Francisco89/tesis/README.md

tesis
=====

El repositorio de mi tesis.
