Francisco89/tesis/Eclipse/Sources y Firmwares de ejemplo/ReadMe.txt

====== CYPRESS USBSUITE SOURCE CODE ==========
============================================== 
Following projects source code is included in this package.

1. CyAPI C++ Static Library.
2. CyUSB C#  DLL.
3. CyUSB3 WDF Kernel mode USB generic driver.

Following directories are included this package.

1.CyAPI_lib_cpp      :This directory contains CyAPI C++ Static Library source code.
  	
  ->ReadMe.txt       :Refer ReadMe.txt file  for more information on CyUSB library.
  
2.CyUSB_dll_csharp   :This directory contains CyUSB C#  DLL source code.

  ->ReadMe.txt       :Refer ReadMe.txt file  for more information on CyAPI library.
   
3.CyUSB3_sys_driver  :This directory contains CyUSB3 WDF kernel mode generic driver source code.

  ->ReadMe.txt       :Refer ReadMe.txt file  for more information on CyUSB3 driver.

4.License

  ->license.rtf      :Software license agreement file.

5.ReadMe.txt
