Francisco89/tesis/Eclipse/Sources y Firmwares de ejemplo/Firmware 300913/LedBlink/readme.txt

El proyecto de ejemplo sin ninguna modificacion. 

Saca una señal intermitente de 0.5 Hz.
