Francisco89/tesis/Informes/Opto/Informe de aislacion_version2.pdf

Titulo: Informe sobre aislaciones ópticas version 0.2
18 de marzo de 2014
autor: Francisco Luis Zurita

## 1 Introducción

En este informe se presenta la aislación a usar en cada canal de entrada y salida de tensión digital previo y posterior al conversor DA del proyecto de adquisición de señales de un banco de motores.

## 2 Especificaciones

El aislador especificado a utilizar es el 6N137, un aislador óptico rápido de 10M bit/s, que satisface nuestros requerimientos ya que la señal digital mas rápida que se necesita aislar es de 52kHz.

## 3 Diseño

El diseño del prototipo se enfoca en medir el comportamiento del aislador ante diferentes corrientes de excitación y condiciones de carga. Dicho diseño se basa en la nota de aplicación 71[1].


1

Para fijar la corriente de excitación se conmuta entre tres resistores por medio de un jumper. Las corrientes de entrada quedarán determinadas por el valor de dicha resistencia. Las mismas son:

I1 =

VCC1 − VLED − VEC
R1

=

5V − 1.4V − 0.2V
180Ω | = 18.9mA

I2 =

VCC1 − VLED − VEC
R2

=

5V − 1.4V − 0.2V
390Ω | = 8.71mA

I2 =

VCC1 − VLED − VEC
R3

=

5V − 1.4V − 0.2V
820Ω | = 4.14mA

El valor de VLED se obtiene de una curva de la hoja de datos y vale aproxi-madamente 1.4V .
Para fijar la carga se conmuta entre tres resistores de pull-up por medio de un jumper. Esta resistencia junto con la de la punta del osciloscopio y la capacitancia de dicha punta conforman el circuito RC de carga a la salida. Las cargas de salida son:

(R4||Rosc)||Cosc = 470Ω||10MΩ||10pF = 470Ω||10pF

(R5||Rosc)||Cosc = 1kΩ||10MΩ||10pF = 999.9Ω||10pF

(R6||Rosc)||Cosc = 10kΩ||10MΩ||10pF = 9.99kΩ||10pF

2

### 3.1 Listado de componentes

Resistores
Valor | Tolerancia | Cantidad | Referencia
180Ω | 5% | 1 | R1
390Ω | 5% | 1 | R2
820Ω | 5% | 1 | R3
470Ω | 5% | 1 | R4
1kΩ | 5% | 3 | R5,7,8
10Ω | 5% | 1 | R6
Capacitores
Valor | Tolerancia | Cantidad | Referencia
0.1 µF | 5% | 2 | C1,2
Circuitos Integrados
Modelo | Fabricante | Cantidad | Referencia
6N137 | ST | 1 | U1

3

## 4 Medición

### 4.1 Banco de Medición

Banco de Medición:

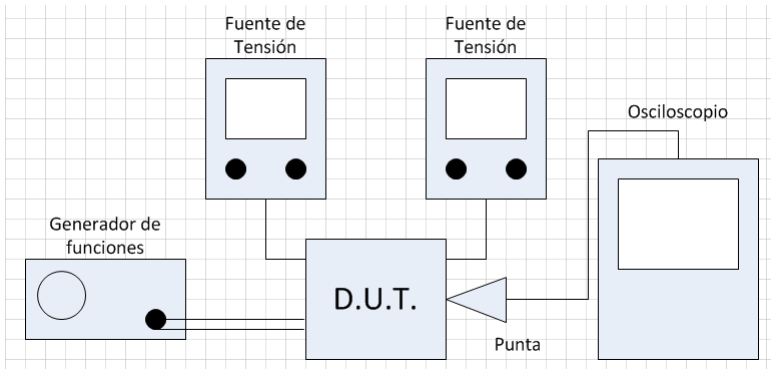
[picture p48: figure]

Figure 1: Banco de medición

- Fuente de Tensión Fair FR-305A 0 − 30V
- Fuente de Tensión Zurich DF1730SB5A 0 − 30V
- Osciloscopio Fluke 192B 60MHz, 500MS/s
Sensibilidad 2mV - 100V/div
Rango de la base de tiempos: 10 ns - 2 min/div
- Punta Fluke VP200 10:1 200MHz, 1.000 V CAT II/600 V CAT III (EN61010-1)
- Generador de Funciones Hing Chang Sweep 9205
Frecuencia: 0.02Hz a 2MHz 7 rangos
Precisión: ±5% (20KHz), ±8%(2MHz)

Rise-time del conjunto generador-punta-osciloscopio: 56.8ns.

Tensión de alimentación de entrada: 5V
Tensión de alimentación de salida: 3.3V
Señal de entrada: Tren de pulsos 0 − 5V a 10kHz

4

### 4.2 Imágenes

¡Reservado para foto¿

### 4.3 Resultados

A continuación mostramos los resultados de las mediciones de retardo, rise-time (tiempo transcurrido entre el 10% y el 90% de la transición de estado bajo a estado alto de la señal) y fall-time (tiempo transcurrido entre el 10% y el 90% de la transición de estado alto a estado bajo de la señal).

Rise-time


Figure 2: Medición de rise-time usando R2 = 390Ω y R4 = 470Ω: 39.6ns

5

Figure 3: Medición de rise-time usando R2 = 390Ω y R4 = 1kΩ: 68.8ns

6

Figure 4: Medición de rise-time usando R2 = 390Ω y R4 = 10kΩ: 628ns

7

Figure 5: Comparación de las figuras anteriores

Fall-time

8

Figure 6: Medición de fise-time usando R2 = 390Ω y R4 = 470Ω: 12ns

9

Figure 7: Medición de fise-time usando R2 = 390Ω y R4 = 1kΩ: 10ns

10

Figure 8: Medición de fise-time usando R2 = 390Ω y R4 = 10kΩ: 8.8ns

11

Figure 9: Comparación de las figuras anteriores

Retardo

12


Figure 10: Medición de retardo usando R1 = 180Ω y R5 = 1kΩ:75ns

13

Figure 11: Medición de retardo usando R2 = 390Ω y R5 = 1kΩ:62.8ns

14


Figure 12: Medición de retardo usando R3 = 820Ω y R5 = 1kΩ:56ns

15

Figure 13: Comparación de las figuras anteriores

Corriente / Carga | 470Ω | 1kΩ | 10kΩ
I1 = 18.9mA | 75ns | 75ns | 76ns
I2 = 8.71mA | 62.8ns | 63.6ns | 62.8ns
I3 = 4.14mA | 56ns | 55.2ns | 56.8ns
Tabla de valores de Retardo.
Corriente / Carga | 470Ω | 1kΩ | 10kΩ
I1 = 18.9mA | 32.8ns | 67.2ns | 624ns
I2 = 8.71mA | 39.6ns | 68.8ns | 628ns
I3 = 4.14mA | 32ns | 67.8ns | 620ns
Tabla de valores de rise-time.
Corriente / Carga | 470Ω | 1kΩ | 10kΩ
I1 = 18.9mA | 9.2ns | 8.8ns | 8.0ns
I2 = 8.71mA | 12ns | 10ns | 8.8ns
I3 = 4.14mA | 17.6ns | 16.8ns | 9.2ns
Tabla de valores de fall-time.
Se observa de las mediciones anteriores que el retardo a la salida no depende de la condición de carga. A su vez, el rise-time y fall-time no dependen de la corriente de excitación.

16

## References

[1] AN71: 10MBd High-Speed Optocoupler Design Guide, Noviembre 2011, Vishay Semiconductors.

17
