Francisco89/tesis/Eclipse/Sources y Firmwares de ejemplo/Firmware 300913/LedParpadeante/readme.txt

El proyecto de ejemplo modificado. 

Saca una señal intermitente que se repite cada 3s, 2s en estado alto y 1s en estado bajo.
