Francisco89/tesis/Eclipse/Sources y Firmwares de ejemplo/Firmware 300913/LedPermanente/readme.txt

El proyecto de ejemplo modificado. 

Saca una en estado alto todo el tiempo.
