Francisco89/tesis/Informes/Precios/Informe de precios.tex

	\documentclass[12pt,a4paper]{article}
\usepackage[utf8]{inputenc}
\usepackage{amsmath}
\usepackage{amsfonts}
\usepackage{amssymb}
\usepackage{graphicx}
\usepackage[spanish]{varioref}
\usepackage{hyperref}
\usepackage{float}
\begin{document}
\setlength{\parindent}{0cm}

Titulo: Informe sobre la adquisición de los conversores AD y DA\\
version 0.1\\
17 de marzo de 2014\\
autor: Francisco Luis Zurita\\

\section{Introducción}

En el presente informe se detalla la búsqueda del conversor ADC7656 y del conversor AD5422, necesarios para el proyecto de adquisición de señales de un banco de motores.

\section{Resumen de componentes}

\begin{tabular}{| l | l | l | l | l |} \hline
Proveedor & N$^\circ$ de parte & Cantidad & Precio unitario & Precio total\\ \hline
YEL & AD7656BSTZ & 5 & U\$S $52.983$ & U\$S $264.915$ \\ \hline
YEL & AD5422AREZ & 3 & U\$S $27.410$ & U\$S $82.230$ \\ \hline \hline
Total & & & & U\$S $347.145$\\ \hline
\end{tabular}

NOTA: Productos cotizados al 11 de marzo de 2014.

\end{document}
