Francisco89/tesis/Informes/Precios/Informe de precios_version2.pdf

Titulo: Informe sobre la adquisici´on de los conversores AD y DA version 0.1
17 de marzo de 2014
autor: Francisco Luis Zurita

## 1 Introducci´on

En el presente informe se detalla la b´usqueda del conversor ADC7656 y del conversor AD5422, necesarios para el proyecto de adquisici´on de se˜nales de un banco de motores.

## 2 Resumen de componentes

Proveedor | N◦ de parte | Cantidad | Precio unitario | Precio total
YEL | AD7656BSTZ | 5 | U$S 52.983 | U$S 264.915
YEL | AD5422AREZ | 3 | U$S 27.410 | U$S 82.230
Total | | | | U$S 347.145
NOTA: Productos cotizados al 11 de marzo de 2014.

1
