Francisco89/tesis/Informes/Filtro/Libro1.xlsx

Frecuencia | desfasaje/div | div | fase | log | - | ARG
1 | 0 |  | 0 | 0 | 0 | 0
2 | 0 |  | 0 | 0.3010299957 | 0 | 0
3 | 0 |  | 0 | 0.4771212547 | 0 | 0
4 | 0 |  | 0 | 0.6020599913 | 0 | 0
5 | 0 |  | 0 | 0.6989700043 | 0 | 0
6 | 0 |  | 0 | 0.7781512504 | 0 | 0
7 | 0 |  | 0 | 0.84509804 | 0 | 0
8 | 0 |  | 0 | 0.903089987 | 0 | 0
9 | 0 |  | 0 | 0.9542425094 | 0 | 0
10 | 0 |  | 0 | 1 | 0 | 0
20 | 0 |  | 0 | 1.301029996 | 0 | 0
30 | 0 |  | 0 | 1.477121255 | 0 | 0
40 | 0 |  | 0 | 1.602059991 | 0 | 0
50 | 0 |  | 0 | 1.698970004 | 0 | 0
60 | 0 |  | 0 | 1.77815125 | 0 | 0
70 | 0 |  | 0 | 1.84509804 | 0 | 0
80 | 0 |  | 0 | 1.903089987 | 0 | 0
90 | 0 |  | 0 | 1.954242509 | 0 | 0
100 | 0 |  | 0 | 2 | 0 | 0
200 | 0 |  | 0 | 2.301029996 | 0 | 0
300 | 0 |  | 0 | 2.477121255 | 0 | 0
400 | 0.1 | 0.0005 | 7.2 | 2.602059991 | -7.2 | -7.2
500 | 0.2 | 0.0002 | 7.2 | 2.698970004 | -7.2 | -7.2
600 | 0.2 | 2e-05 | 0.864 | 2.77815125 | -0.864 | -0.864
700 | 0.2 | 2e-05 | 1.008 | 2.84509804 | -1.008 | -1.008
800 | 0.2 | 2e-05 | 1.152 | 2.903089987 | -1.152 | -1.152
900 | 0.2 | 0.0002 | 12.96 | 2.954242509 | -12.96 | -12.96
1000 | 1.6 | 2e-05 | 11.52 | 3 | -11.52 | -11.52
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
