Francisco89/tesis/Informes/material/diseno/GPIO DATA_Plots.xlsx

Sheet: IOL_1.63V_00
IO VDD | IOL/ IOH | Drive Strength | Forced VDD | Unit#1 |  |  |  |  |  |  |  | Unit#2 |  |  |  |  |  |  |  | Unit#3 |  |  |  |  |  |  |  | Unit#4 |  |  |  |  |  |  |  | Unit#5
 |  |  |  | GPIO#47 | GPIO#46 | GPIO#53 | GPIO#54 | GPIO#33 | GPIO#34 | GPIO#6 | GPIO#7 | GPIO#47 | GPIO#46 | GPIO#53 | GPIO#54 | GPIO#33 | GPIO#34 | GPIO#6 | GPIO#7 | GPIO#47 | GPIO#46 | GPIO#53 | GPIO#54 | GPIO#33 | GPIO#34 | GPIO#6 | GPIO#7 | GPIO#47 | GPIO#46 | GPIO#53 | GPIO#54 | GPIO#33 | GPIO#34 | GPIO#6 | GPIO#7 | GPIO#47 | GPIO#46 | GPIO#53 | GPIO#54 | GPIO#33 | GPIO#34 | GPIO#6 | GPIO#7
1.63 | IOL | 00 | 0 | -0.02 | -0.02 | -0.06 | -0.06 | -0.02 | 0.11 | -0.02 | -0.02 | -0.07 | -0.04 | -0.06 | -0.06 | -0.02 | -0.02 | -0.02 | -0.02 | -0.02 | -0.02 | -0.06 | -0.06 | -0.02 | -0.02 | -0.02 | -0.02 | -0.02 | -0.02 | -0.06 | -0.06 | -0.02 | -0.02 | -0.02 | -0.02 | -0.08 | -0.02 | -0.06 | -0.06 | -0.02 | -0.02 | -0.02 | -0.02
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
