Francisco89/tesis/Informes/Filtro/img/filtro3.PNG

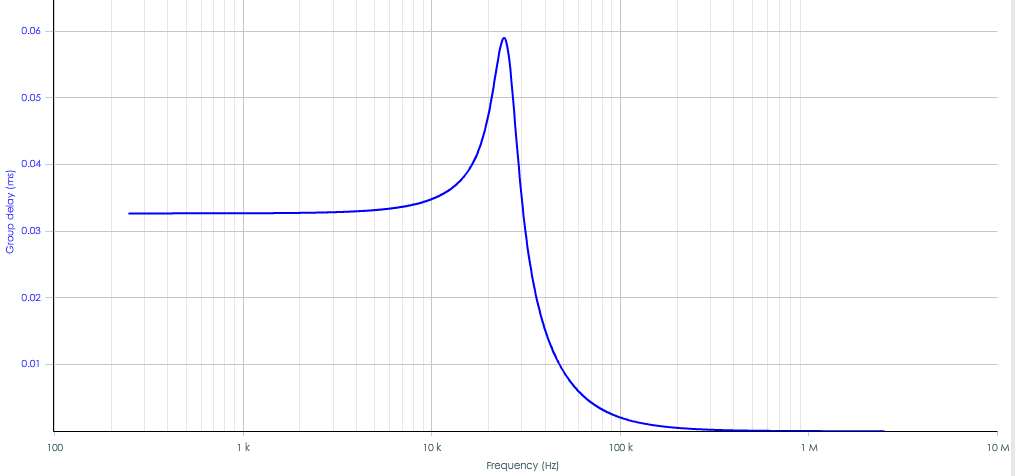
Informes/Filtro/img/filtro3.PNG
