Francisco89/tesis/Informes/Filtro/img/filtro9.PNG

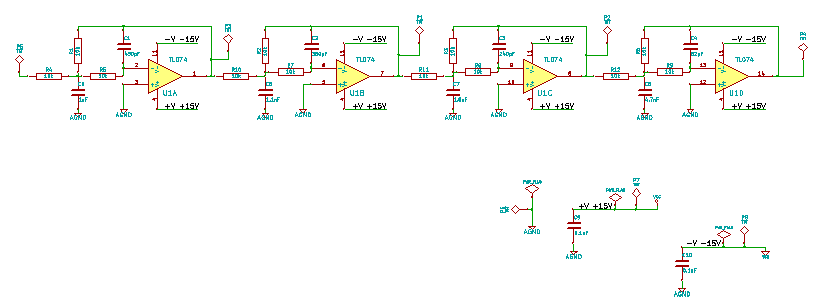
Informes/Filtro/img/filtro9.PNG
