Francisco89/tesis/Informes/Filtro/img/filtro10.PNG

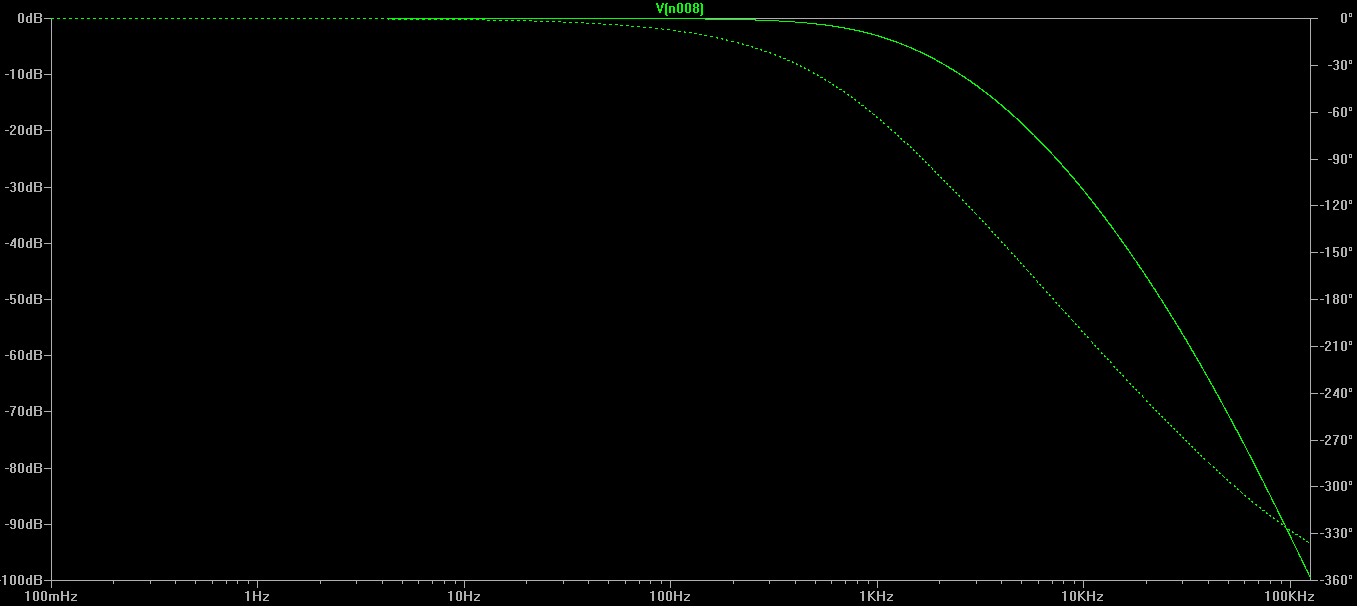
Informes/Filtro/img/filtro10.PNG
