Francisco89/tesis/Informes/Filtro/img/filtro11.PNG

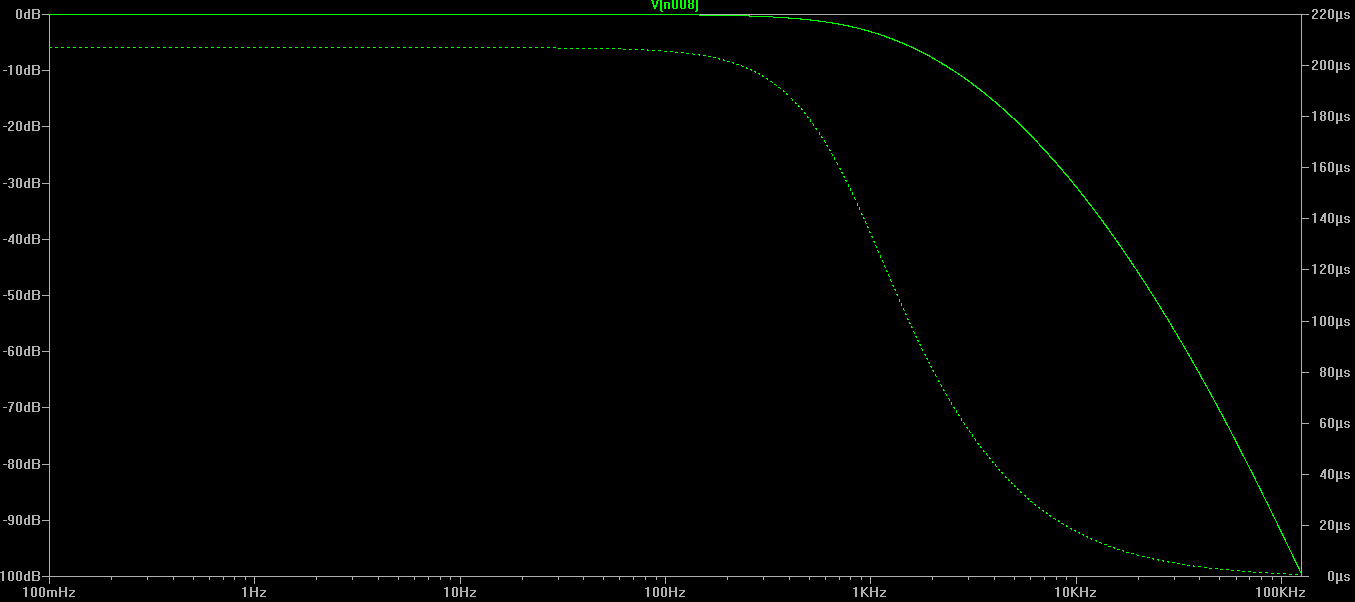
Informes/Filtro/img/filtro11.PNG
