Francisco89/tesis/Informes/Filtro/img/foto2.png

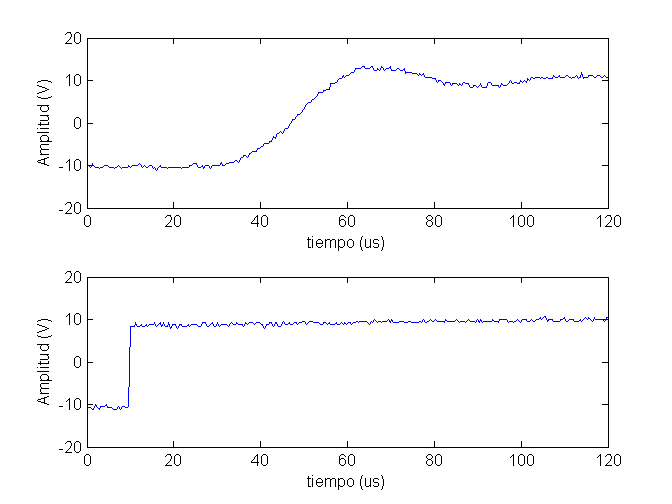
Informes/Filtro/img/foto2.png
