Francisco89/tesis/Informes/Filtro/img/foto4.png

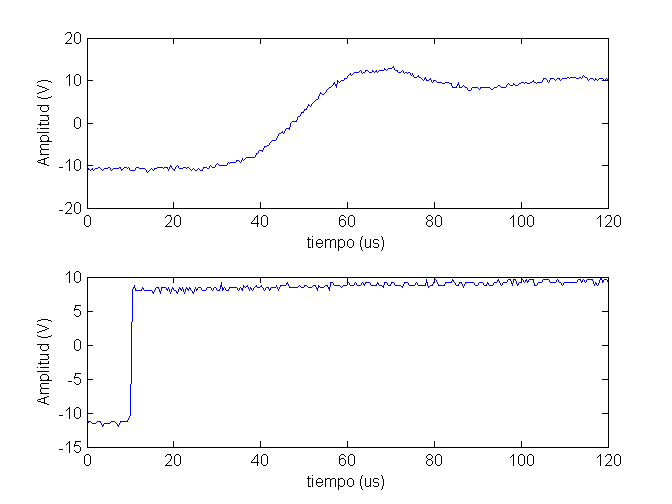
Informes/Filtro/img/foto4.png
