Francisco89/tesis/Informes/Filtro/img/foto5.png

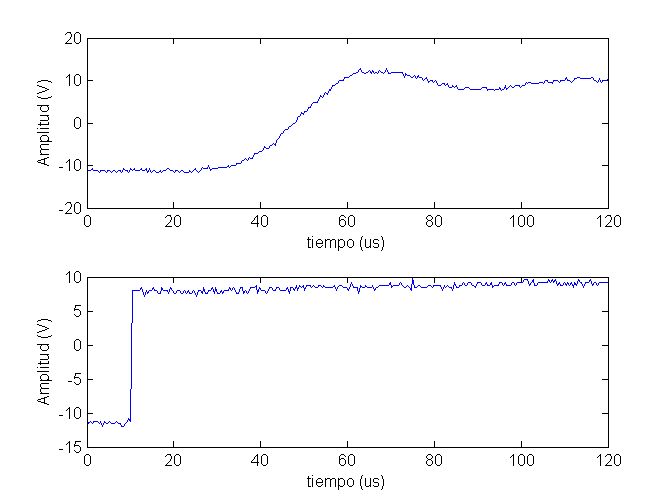
Informes/Filtro/img/foto5.png
