Francisco89/tesis/Informes/Filtro/img/foto7.png

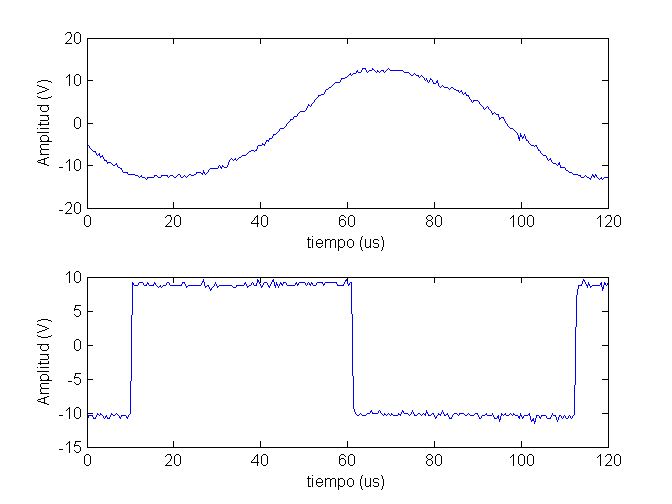
Informes/Filtro/img/foto7.png
