Francisco89/tesis/Informes/Filtro/img/foto8.png

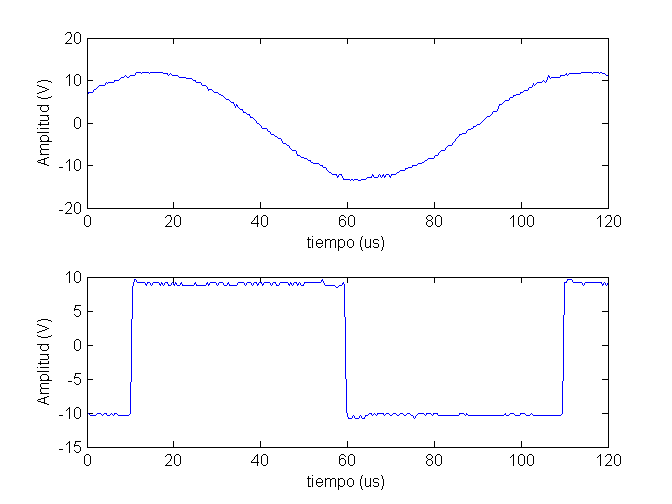
Informes/Filtro/img/foto8.png
