Francisco89/tesis/Informes/Filtro/img/foto9.png

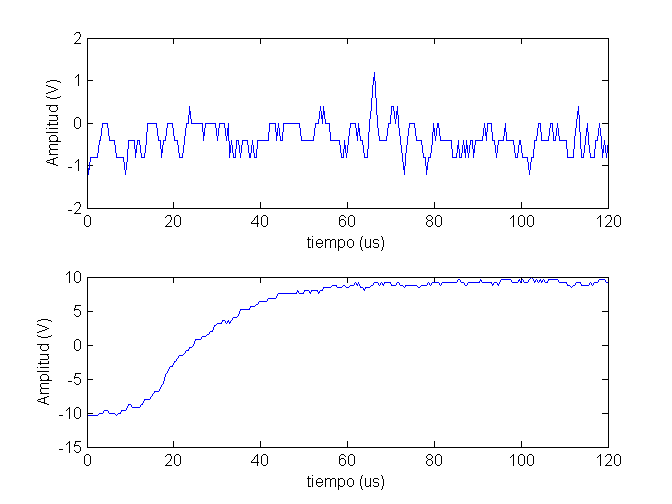
Informes/Filtro/img/foto9.png
