Francisco89/tesis/Informes/Filtro/img/retardo.PNG

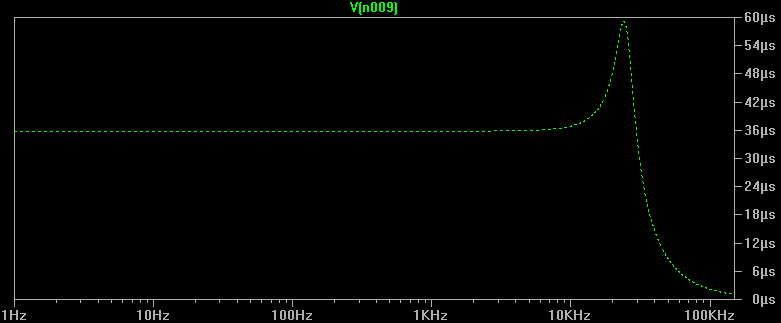
Informes/Filtro/img/retardo.PNG
