Francisco89/tesis/Informes/material/diseno/entrada2.PNG

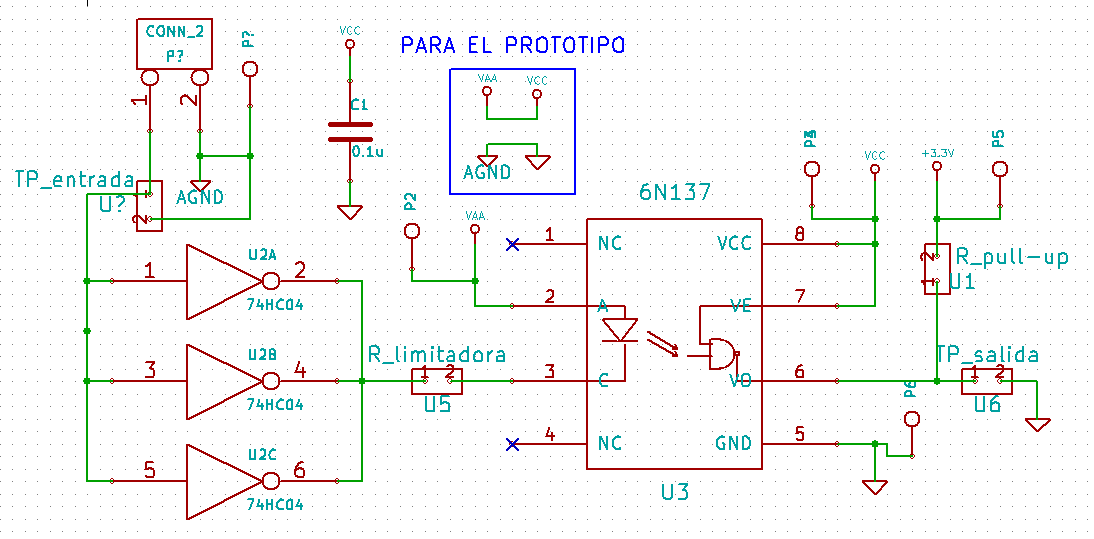
Informes/material/diseno/entrada2.PNG
