Francisco89/tesis/Informes/material/diseno/entrada_footprint.PNG

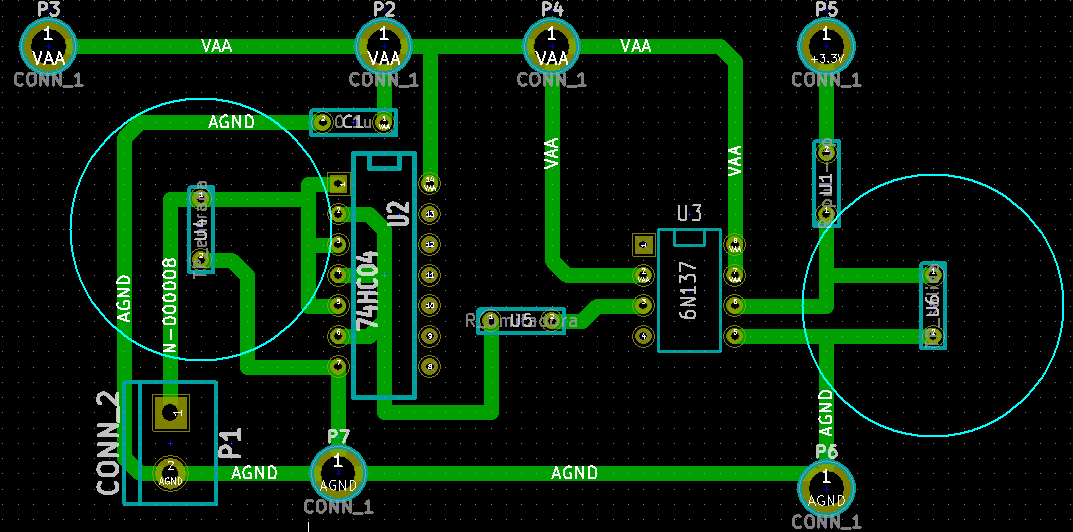
Informes/material/diseno/entrada_footprint.PNG
