Francisco89/tesis/Placa adquisidora/Componentes Placa.ods

 | Precio (por unidad)
 | RS | Mouser | Electronic Components | Digikey | Arrow | Empresa | Modelo | Bits | Settling time | Encapsulado | Interfaz | Salida | Comentarios
ADC
1 |  |  |  |  |  | Analog Devices | AD7656 | 16 | 3.1us | ST-64-2 | Serie/Paralelo | 0.2 a V_drive-0.2 | Es mas o menos el mismo tiempo de conversion en modo paralelo o serie
2
3
DAC
1 | POA | 14.15 a 26.82 | - | 6.69 a 15.35 | - | Texas Instruments | DAC8830 | 16 | 1us | SO-8 | SPI | 0 a +V_ref | Reset a zero code
2 | POA | 14.85 a 22 | - | 14.85 a 26.82 | - | Texas Instruments | DAC8831 | 16 | 1us | SO-14 y QFN-14 | SPI | -V_ref a +V_ref | Reset a zero code
3 | - | 10.48 (x148) | - | 12.16 a 15.22 | - | Texas Instruments | DAC8832 | 16 | 1us | QFN-14 | SPI | unipolar o bipolar | Reset a mid code
4 | POA | 22.48 | - | 22.0 | - | Texas Instruments | DAC8871 | 16 | 1us | TSSOP-16 | SPI | V_ref_H a V_ref_L | V_ref_H/L +/- 18V
5 | - | 10.0 | - | 10.0 | - | Analog Devices | AD5667R | 16 | 4us | LFCSP y MSOP-10 | I^2C | 0 a V_DD | Referencia interna
6 | - | 9.20 | - | 5 a 10 | - | Analog Devices | AD5667 | 16 | 4us | LFCSP y MSOP-10 | I^2C | 0 a V_DD | Referencia externa
7 | - | 10.0 | - | 5 a 10 | - | Analog Devices | AD5663R | 16 | 4us | LFCSP y MSOP-10 | SPI | 0 a V_DD | Ref int o ext
8 |  | 15.34 | - | 13 a 18 | - | Linear Tecnologies | LTC2641 | 16 | 1us | MSOP-8 y DFN | SPI | 0 a +V_ref
9 |  | - | - | 13 a 18 | - | Linear Tecnologies | LTC2642 | 16 | 1us | MSOP-10 y DFN | SPI | 0 a +V_ref y +/-V_ref
10 | - | - | - | - | - | Maxim | - | - | - | - | - | - | Solo de 12 bits
Aislador digital
1
2
3
Aislador analógico
1 |  |  |  |  |  |  | ISO124
2
3
Drivers analógicos
1 |  |  |  |  |  |  | AD8021
2 |  |  |  |  |  |  | AD8610
3 |  |  |  |  |  |  | AD797
