Francisco89/tesis/Informes/material/adq_retardos_hc04/retardo_de_bajada/retardo_de_bajada.JPG

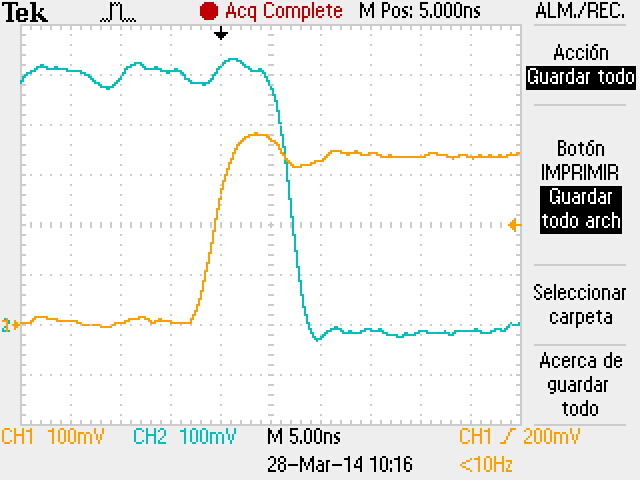
Informes/material/adq_retardos_hc04/retardo_de_bajada/retardo_de_bajada.JPG
