Francisco89/tesis/Informes/material/adq_retardos_hc04/retardo_de_subida/retardo_de_subida.JPG

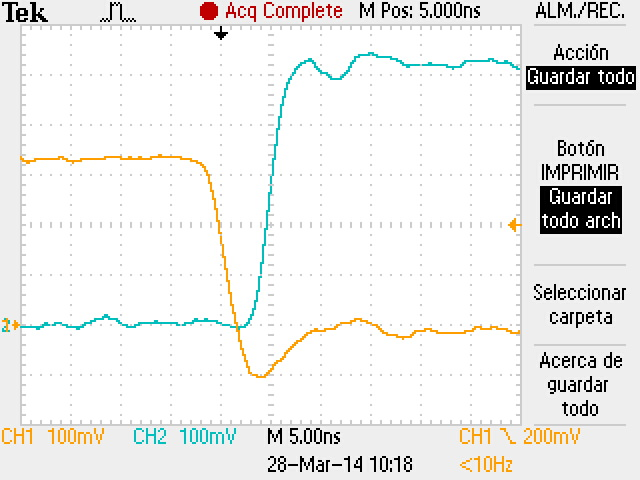
Informes/material/adq_retardos_hc04/retardo_de_subida/retardo_de_subida.JPG
