Francisco89/tesis/Placa adquisidora/placa yaki/Placa 02 _ Encoder #2.pdf

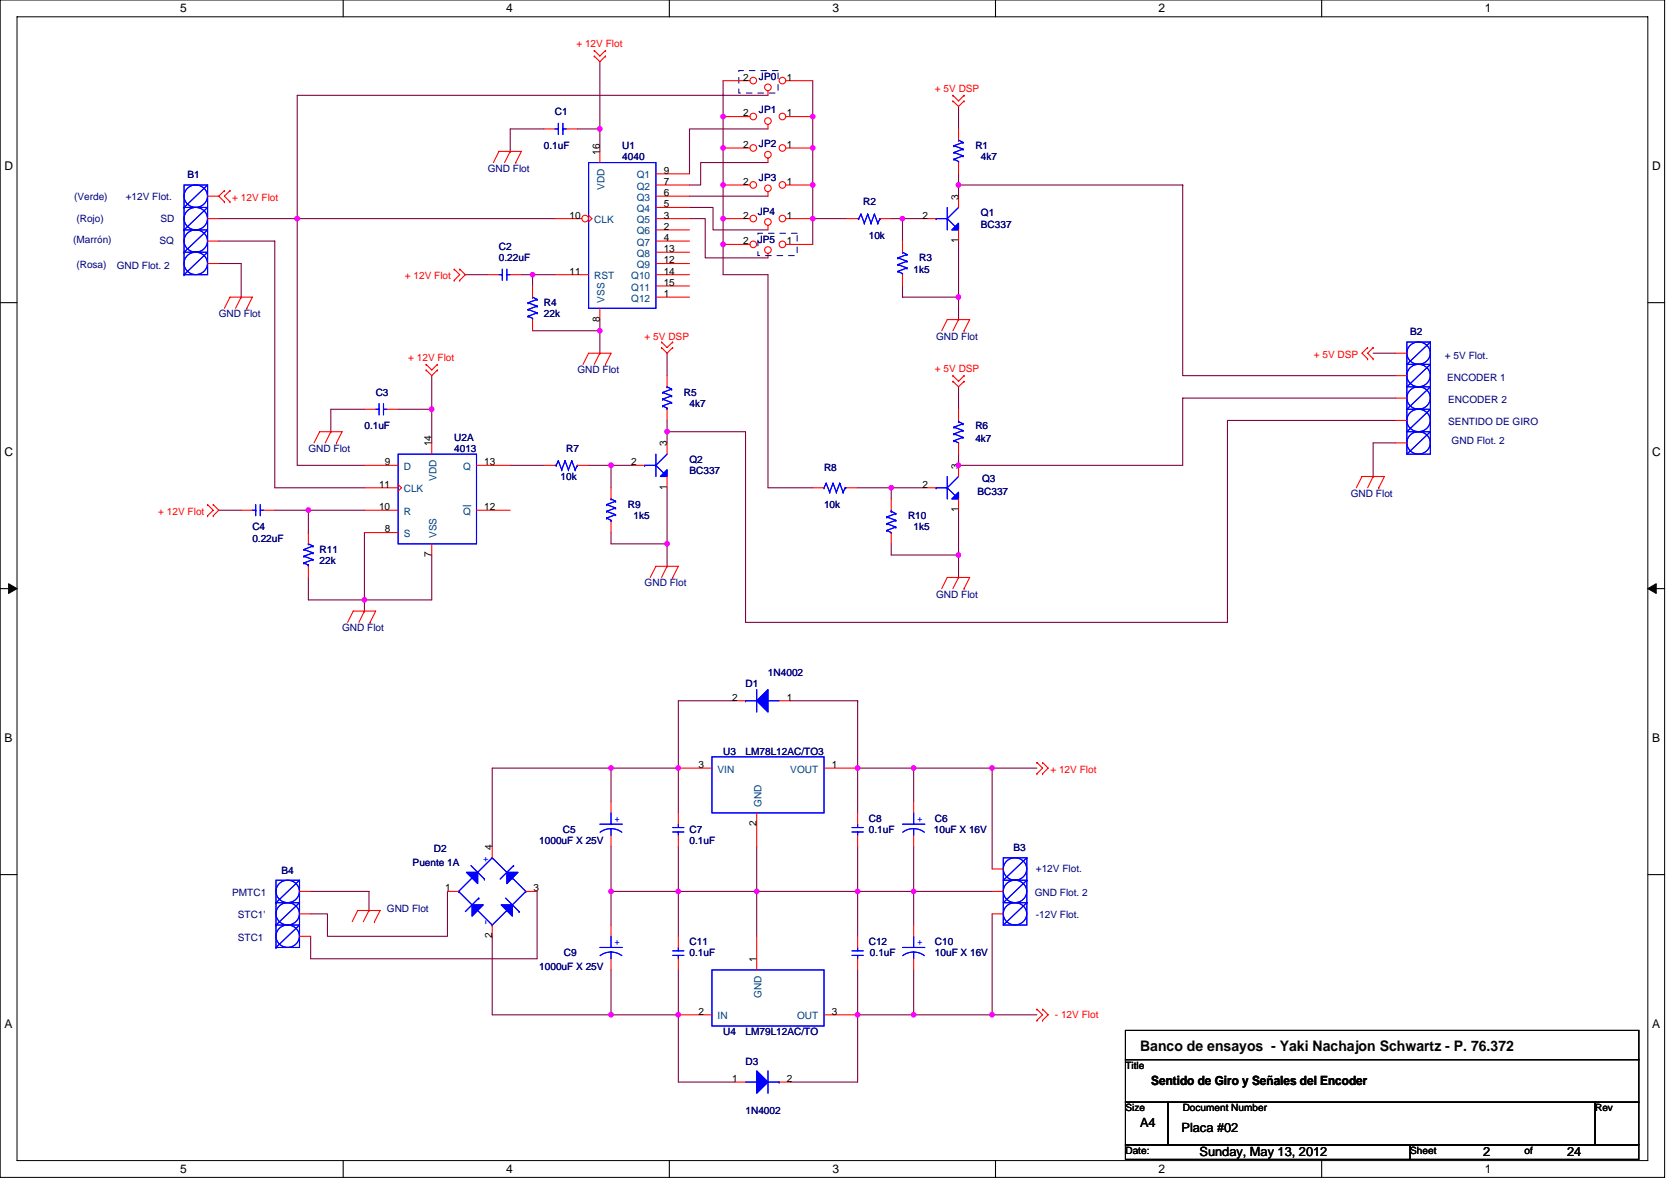
[picture p87: page 1]

Banco de ensayos - Yaki Nachajon Schwartz - P. 76.372

Title
Sentido de Giro y Señales del Encoder

Size Size Size A4 A4 A4 | Document Number Document Number Document Number Placa #02 Placa #02 Placa #02 | Rev Rev Rev

Date: Date: Date: Sunday, May 13, 2012 Sunday, May 13, 2012 Sunday, May 13, 2012 | Sheet Sheet Sheet 2 2 2 of of of 24 24 24
