Francisco89/tesis/Placa adquisidora/placa yaki/Placa 08 _ Filtro ANEXO PLACA #.pdf

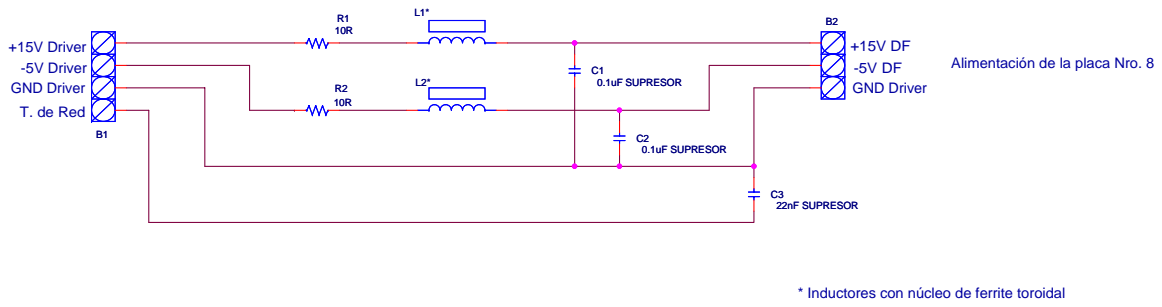
[picture p88: page 1]
+15V Driver -5V Driver GND Driver T. de Red; +15V DF -5V DF GND Driver; C1 0.1uF SUPRESOR; C2 0.1uF SUPRESOR; C3 22nF SUPRESOR

Alimentación de la placa Nro. 8

* Inductores con núcleo de ferrite toroidal

Banco de ensayos - Yaki Nachajon Schwartz - P. 76.372

Title
Filtro para las alimentaciones de la placa #08

Size Size Size A4 A4 A4 | Document Number Document Number Document Number Placa Anexo #08 Placa Anexo #08 Placa Anexo #08 | Rev Rev Rev

Date: Date: Date: Sunday, May 13, 2012 Sunday, May 13, 2012 Sunday, May 13, 2012 | Sheet Sheet Sheet 12 12 12 of of of 24 24 24
