Francisco89/tesis/Placa adquisidora/placa yaki/Placa 13 _ Placa #13 (CF-PWM).pdf

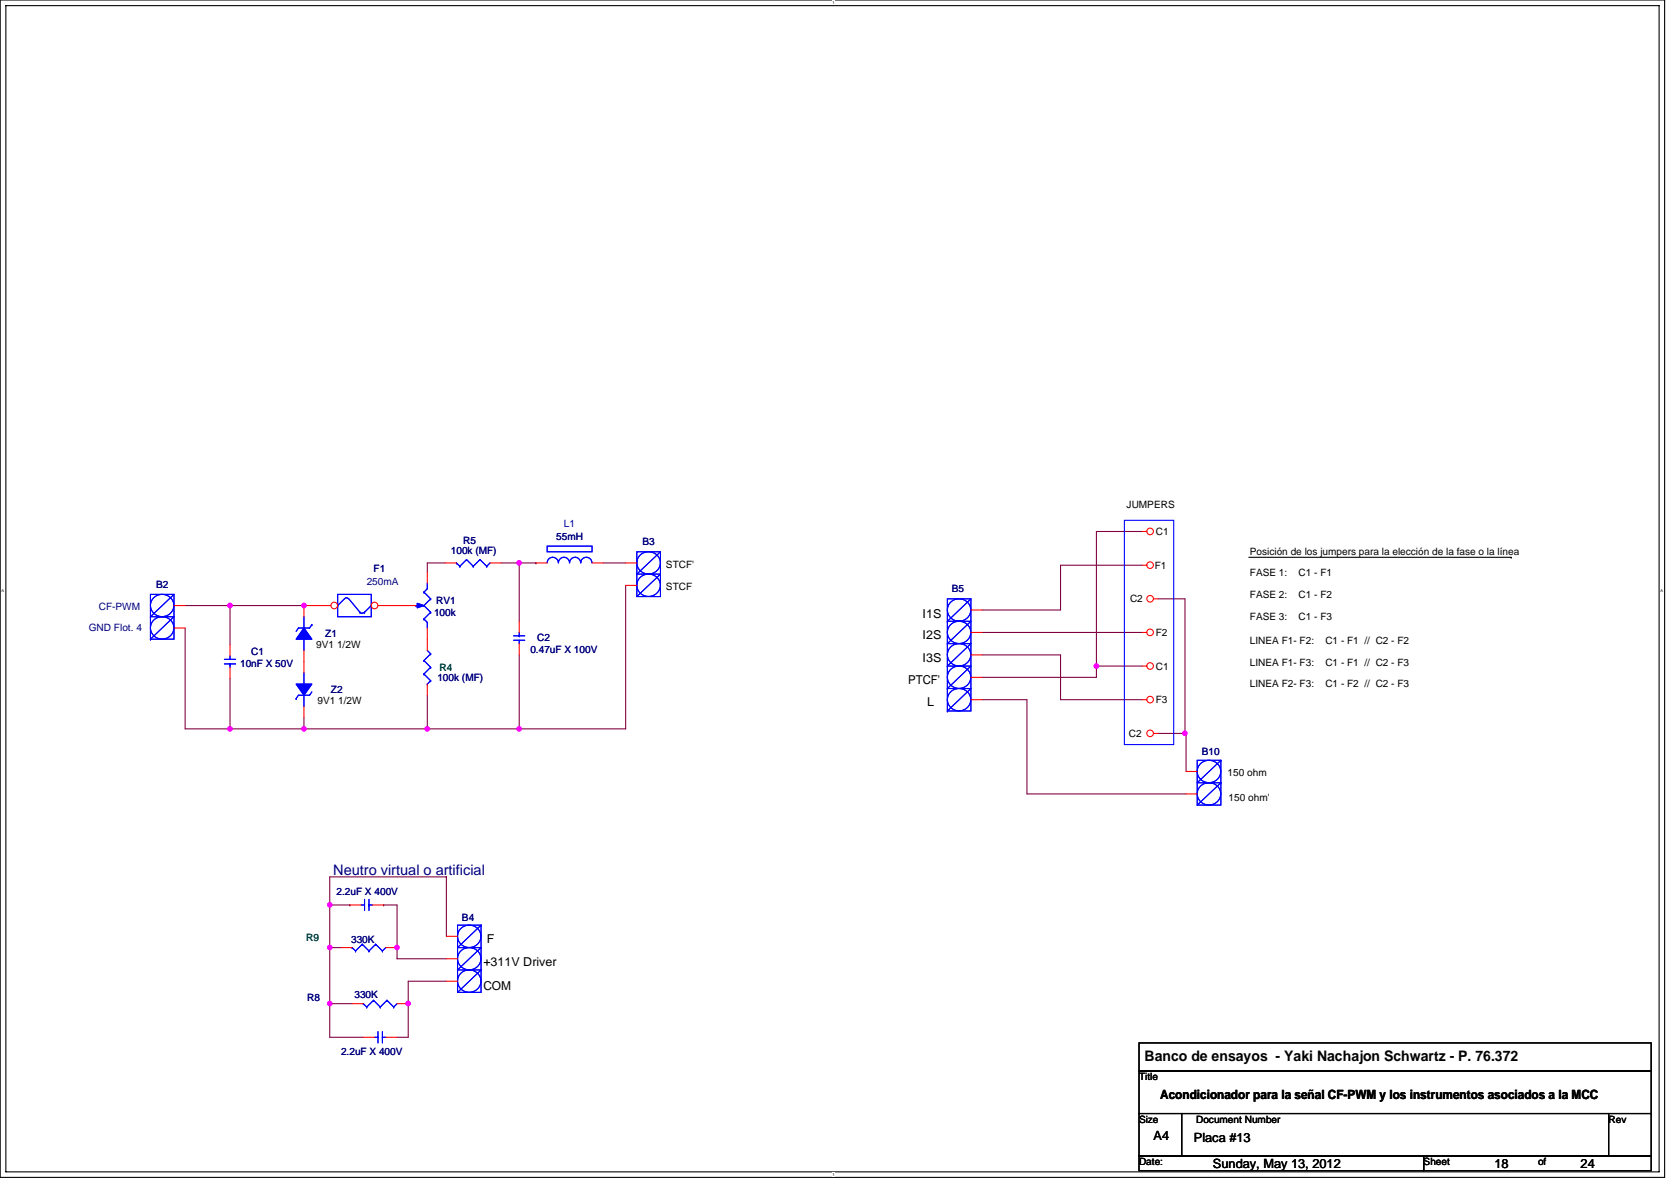
[picture p89: page 1]
COM; +311V Driver; JUMPERS; PTCF'; CF-PWM; GND Flot. 4; STCF'; STCF; 150 ohm; 150 ohm'; FASE 1: C1 - F1; FASE 2: C1 - F2; FASE 3: C1 - F3; LINEA F1- F2: C1 - F1 // C2 - F2; LINEA F1- F3: C1 - F1 // C2 - F3; LINEA F2- F3: C1 - F2 // C2 - F3

Posición de los jumpers para la elección de la fase o la línea

Neutro virtual o artificial

Banco de ensayos - Yaki Nachajon Schwartz - P. 76.372

Title
Acondicionador para la señal CF-PWM y los instrumentos asociados a la MCC

Size Size Size A4 A4 A4 | Document Number Document Number Document Number Placa #13 Placa #13 Placa #13 | Rev Rev Rev

Date: Date: Date: Sunday, May 13, 2012 Sunday, May 13, 2012 Sunday, May 13, 2012 | Sheet Sheet Sheet 18 18 18 of of of 24 24 24
