Francisco89/tesis/Placa adquisidora/placa yaki/Placa 17 & 18 (Fuentes) _ Placa Anexo.pdf

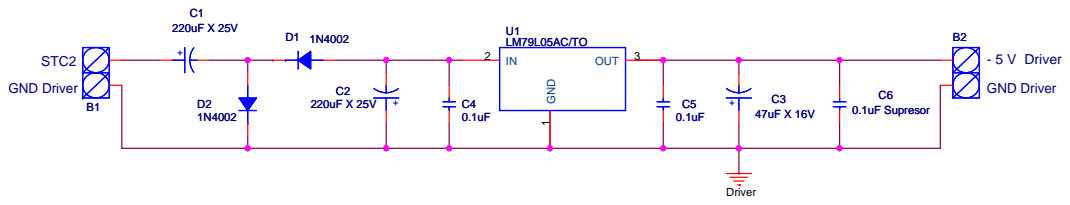
[picture p90: page 1]

Banco de ensayos - Yaki Nachajon Schwartz - P. 76.372

Title
Fuente de alimentación regulada (-5V)

Size Size Size A4 A4 A4 | Document Number Document Number Document Number Placa #18 Placa #18 Placa #18 | Rev Rev Rev

Date: Date: Date: Sunday, May 13, 2012 Sunday, May 13, 2012 Sunday, May 13, 2012 | Sheet Sheet Sheet 23 23 23 of of of 24 24 24
