Francisco89/tesis/Placa adquisidora/placa yaki/Placa 17 & 18 (Fuentes) _ Placa.pdf

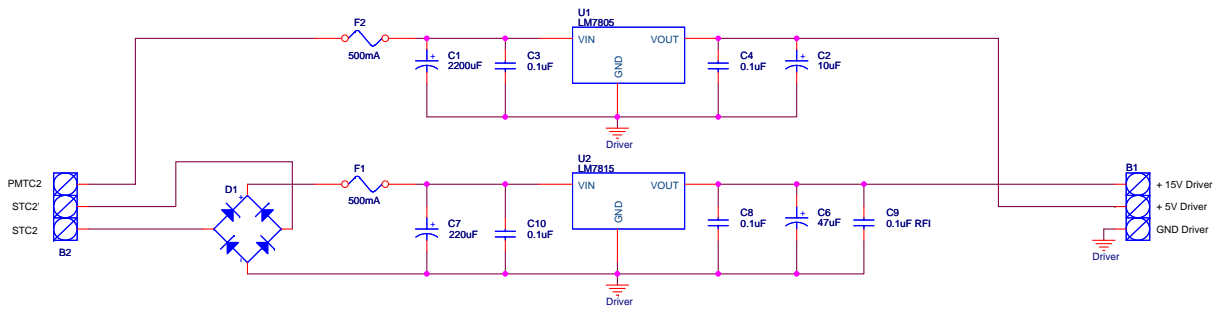
[picture p91: page 1]

Banco de ensayos - Yaki Nachajon Schwartz - P. 76.372
Title
Fuentes de alimentación regulada (+5V y +15V)

Size Size Size A4 A4 A4 | Document Number Document Number Document Number Placa #17 Placa #17 Placa #17 | Rev Rev Rev

Date: Date: Date: Sunday, May 13, 2012 Sunday, May 13, 2012 Sunday, May 13, 2012 | Sheet Sheet Sheet 22 22 22 of of of 24 24 24
