Francisco89/tesis/Placa adquisidora/placa yaki/Placa 05 _ S.pdf

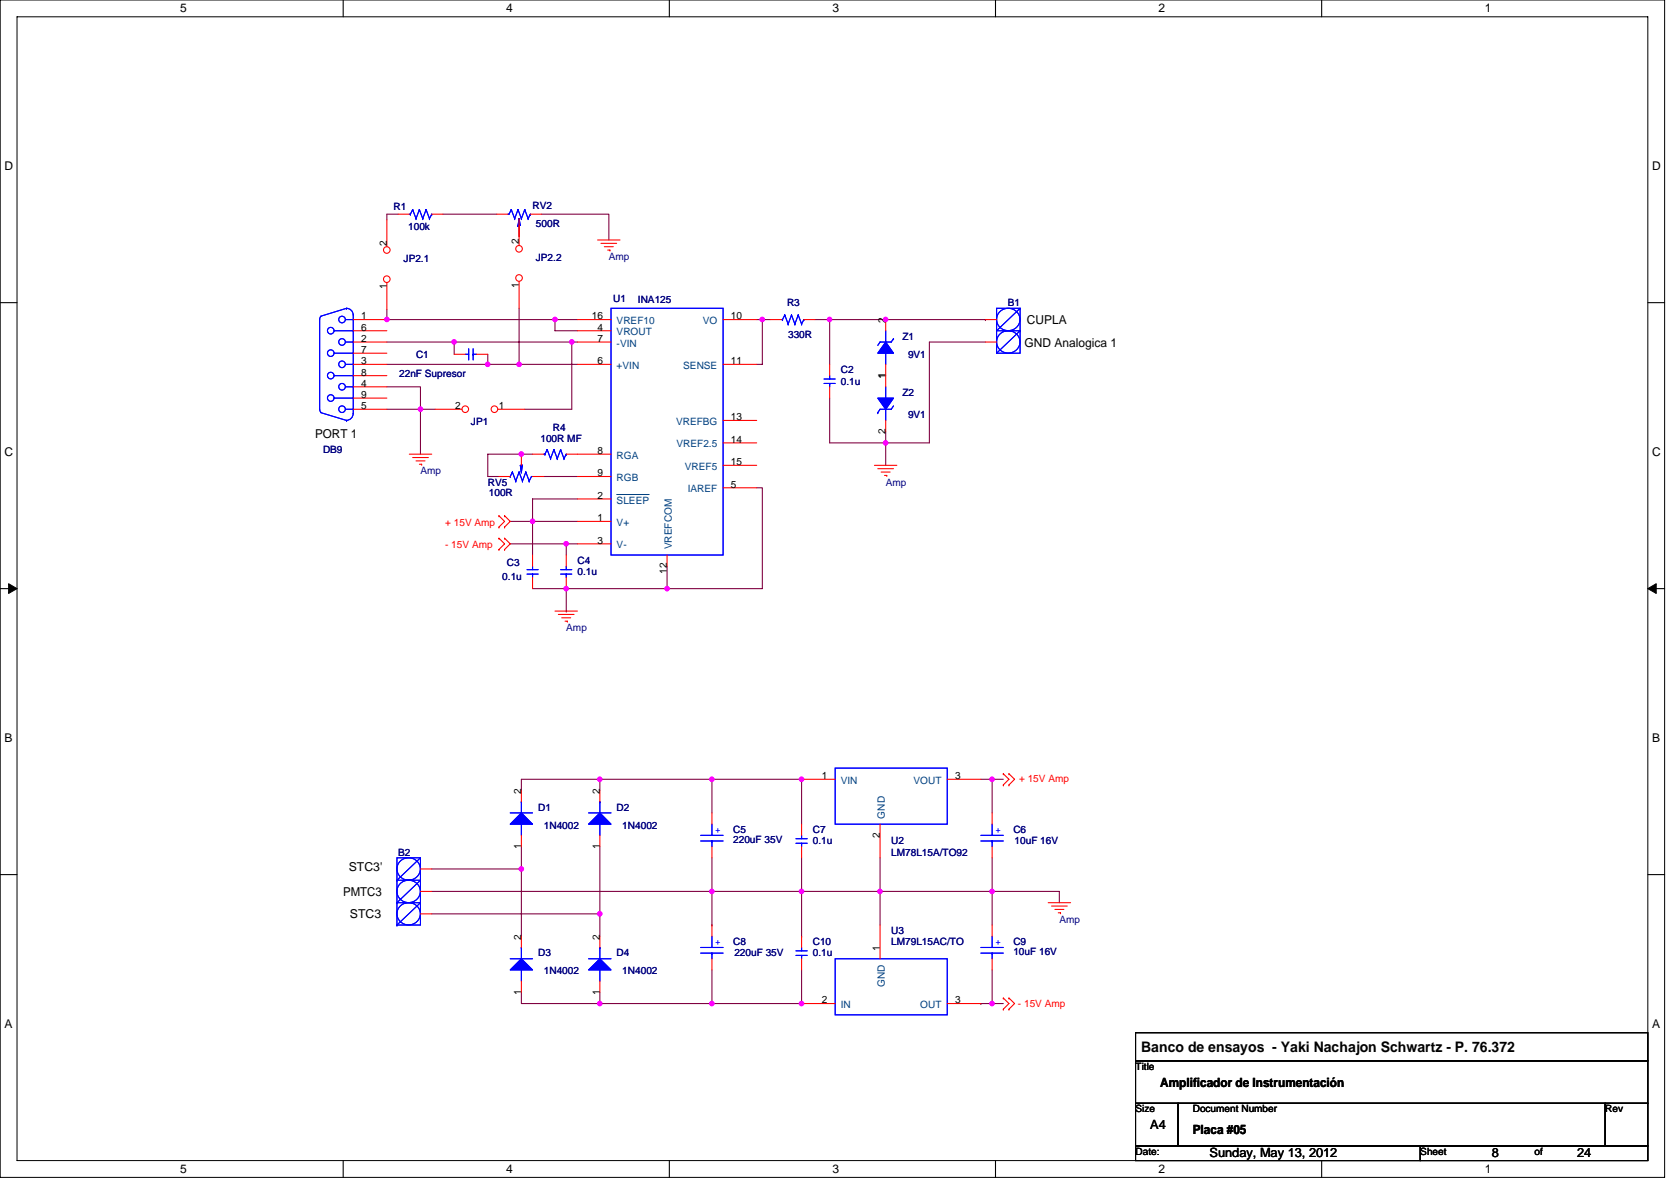
[picture p92: page 1]

Banco de ensayos - Yaki Nachajon Schwartz - P. 76.372

Size Size Size A4 A4 A4 | Document Number Document Number Document Number Placa #05 Placa #05 Placa #05 | Rev Rev Rev

Date: Date: Date: Sunday, May 13, 2012 Sunday, May 13, 2012 Sunday, May 13, 2012 | Sheet Sheet Sheet 8 8 8 of of of 24 24 24
