Francisco89/tesis/Placa adquisidora/placa yaki/Placa 06 _ Dínamo Taq #6.pdf

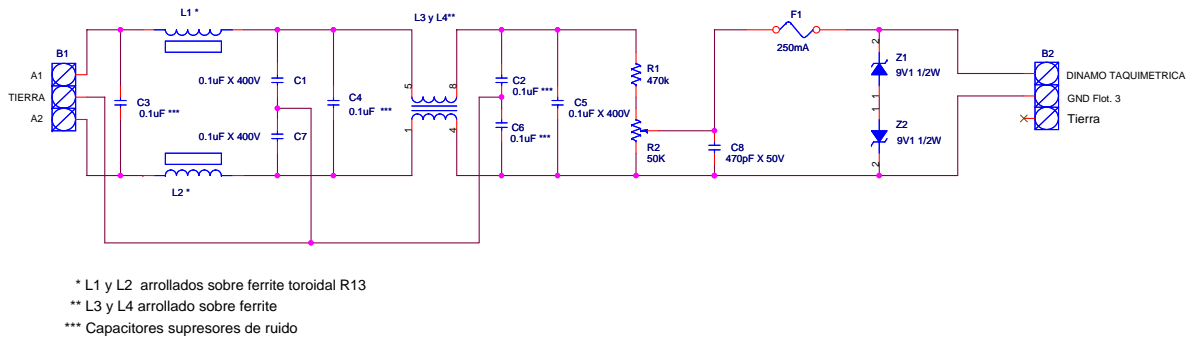
[picture p93: page 1]

* L1 y L2 arrollados sobre ferrite toroidal R13
** L3 y L4 arrollado sobre ferrite
*** Capacitores supresores de ruido

Banco de ensayos - Yaki Nachajon Schwartz - P. 76.372

Title
Acondicionador de señal para la dínamo taquimetrica

Size Size Size A4 A4 A4 | Document Number Document Number Document Number Placa #06 Placa #06 Placa #06 | Rev Rev Rev

Date: Date: Date: Sunday, May 13, 2012 Sunday, May 13, 2012 Sunday, May 13, 2012 | Sheet Sheet Sheet 9 9 9 of of of 24 24 24
