Francisco89/tesis/Placa adquisidora/placa yaki/Placa 07 _ Sensado de Corriente.pdf

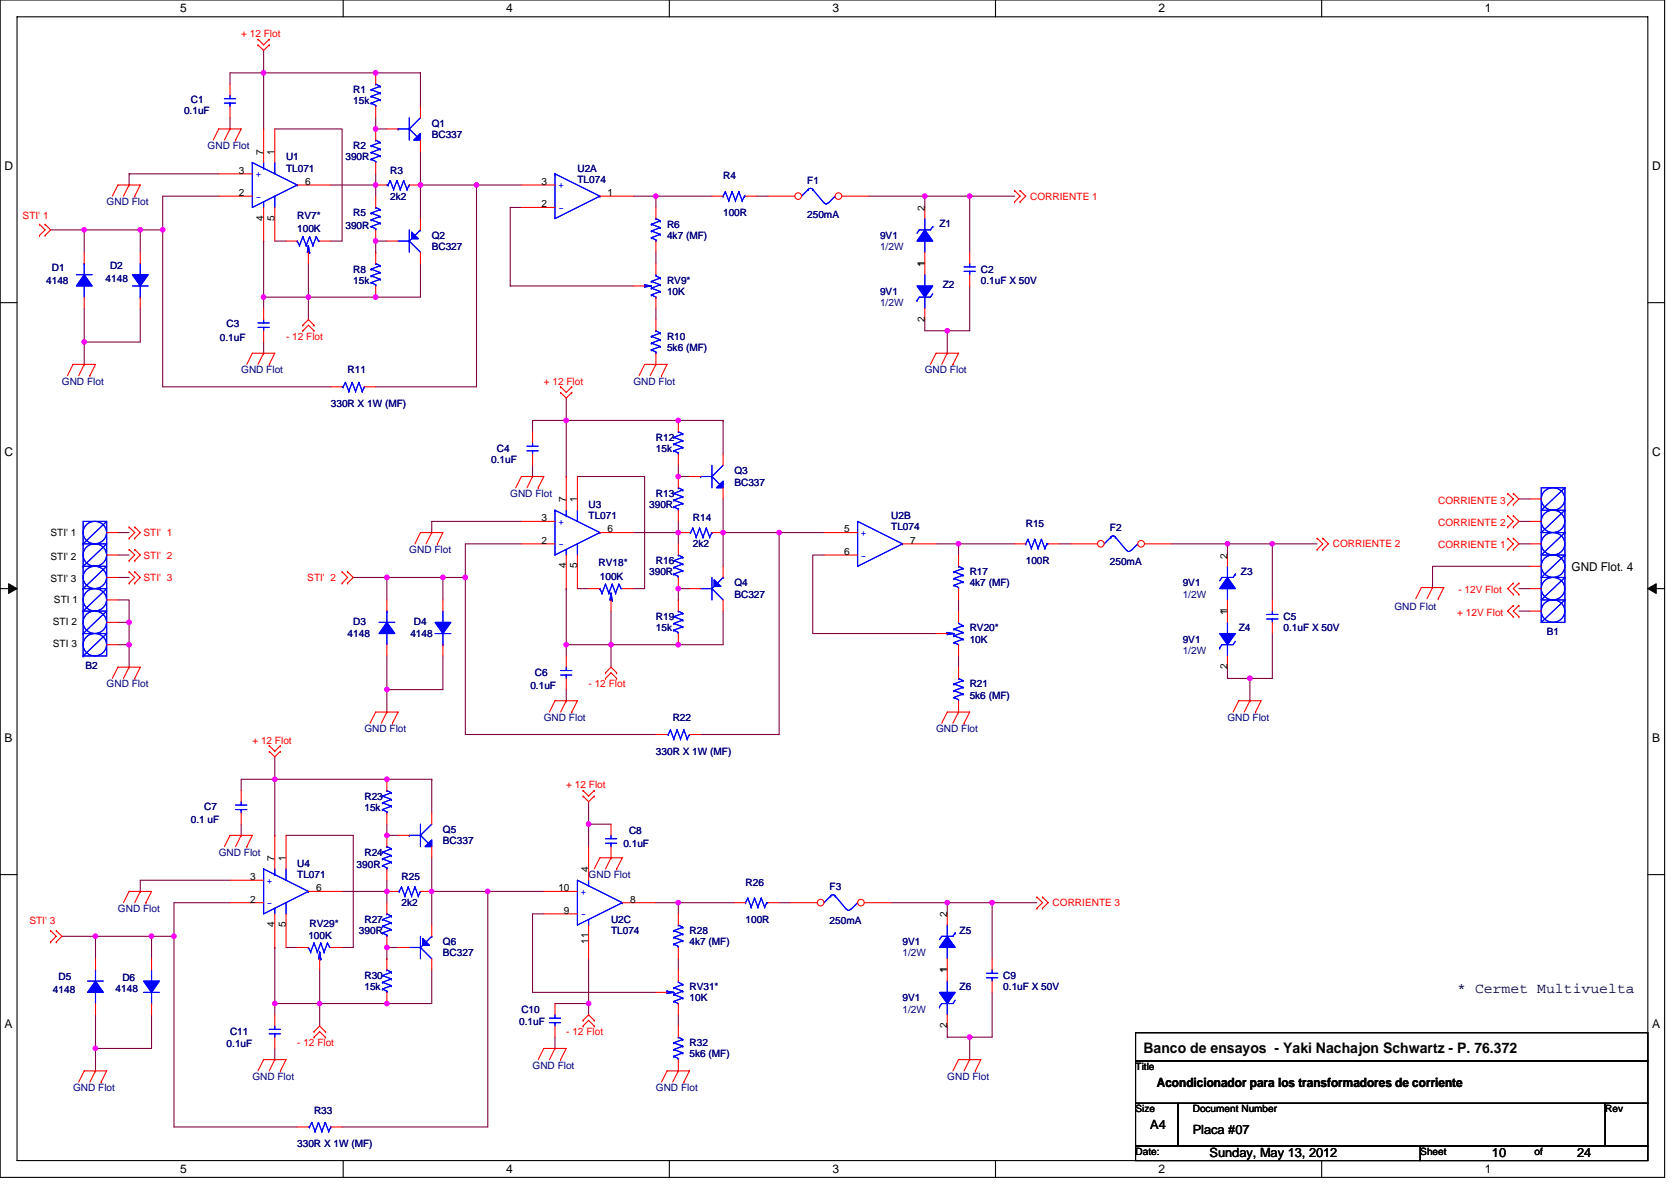
[picture p94: page 1]

Banco de ensayos - Yaki Nachajon Schwartz - P. 76.372
Title
Acondicionador para los transformadores de corriente

Size Size Size A4 A4 A4 | Document Number Document Number Document Number Placa #07 Placa #07 Placa #07 | Rev Rev Rev

Date: Date: Date: Sunday, May 13, 2012 Sunday, May 13, 2012 Sunday, May 13, 2012 | Sheet Sheet Sheet 10 10 10 of of of 24 24 24
