Francisco89/tesis/Placa adquisidora/placa yaki/Placa 08 _ 1_S.pdf

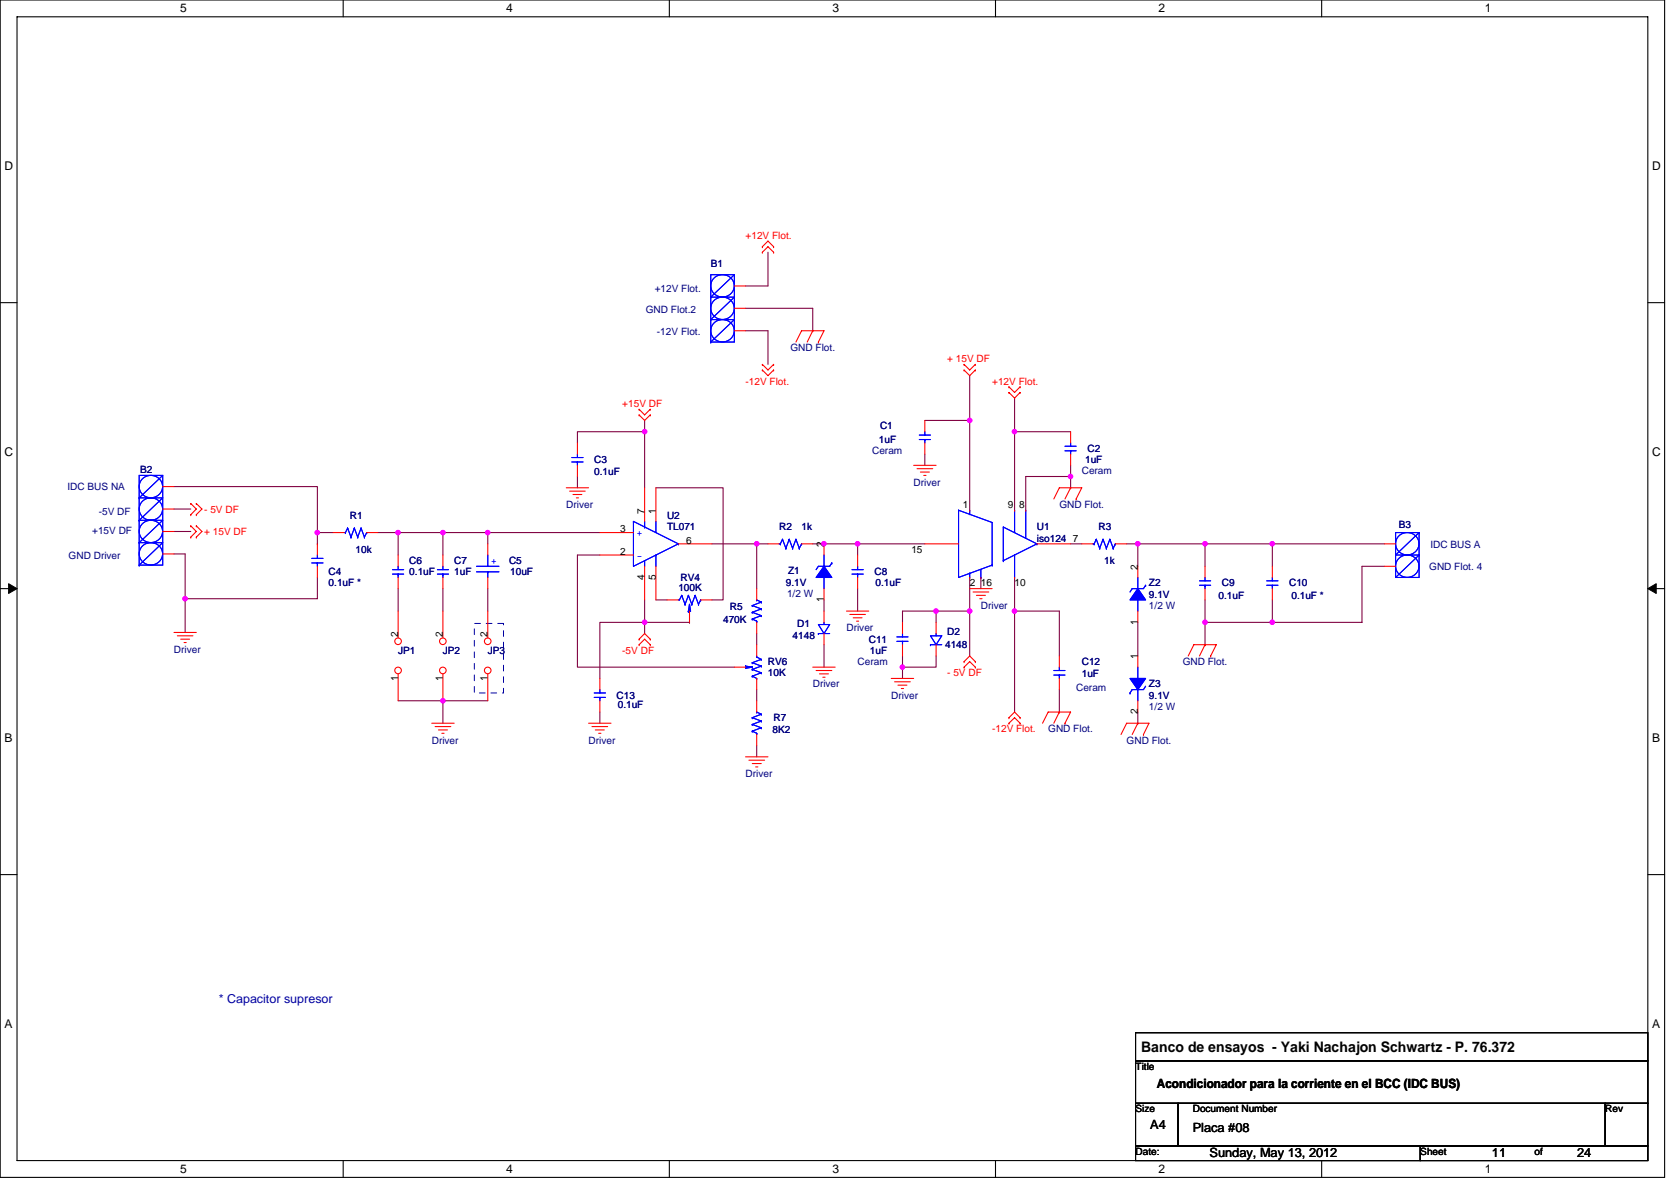
[picture p95: page 1]

Banco de ensayos - Yaki Nachajon Schwartz - P. 76.372

Title
Acondicionador para la corriente en el BCC (IDC BUS)

Size Size Size A4 A4 A4 | Document Number Document Number Document Number Placa #08 Placa #08 Placa #08 | Rev Rev Rev

Date: Date: Date: Sunday, May 13, 2012 Sunday, May 13, 2012 Sunday, May 13, 2012 | Sheet Sheet Sheet 11 11 11 of of of 24 24 24
