Francisco89/tesis/Placa adquisidora/placa yaki/Placa 09 _ Salidas rápidas opto.pdf

M4

M4

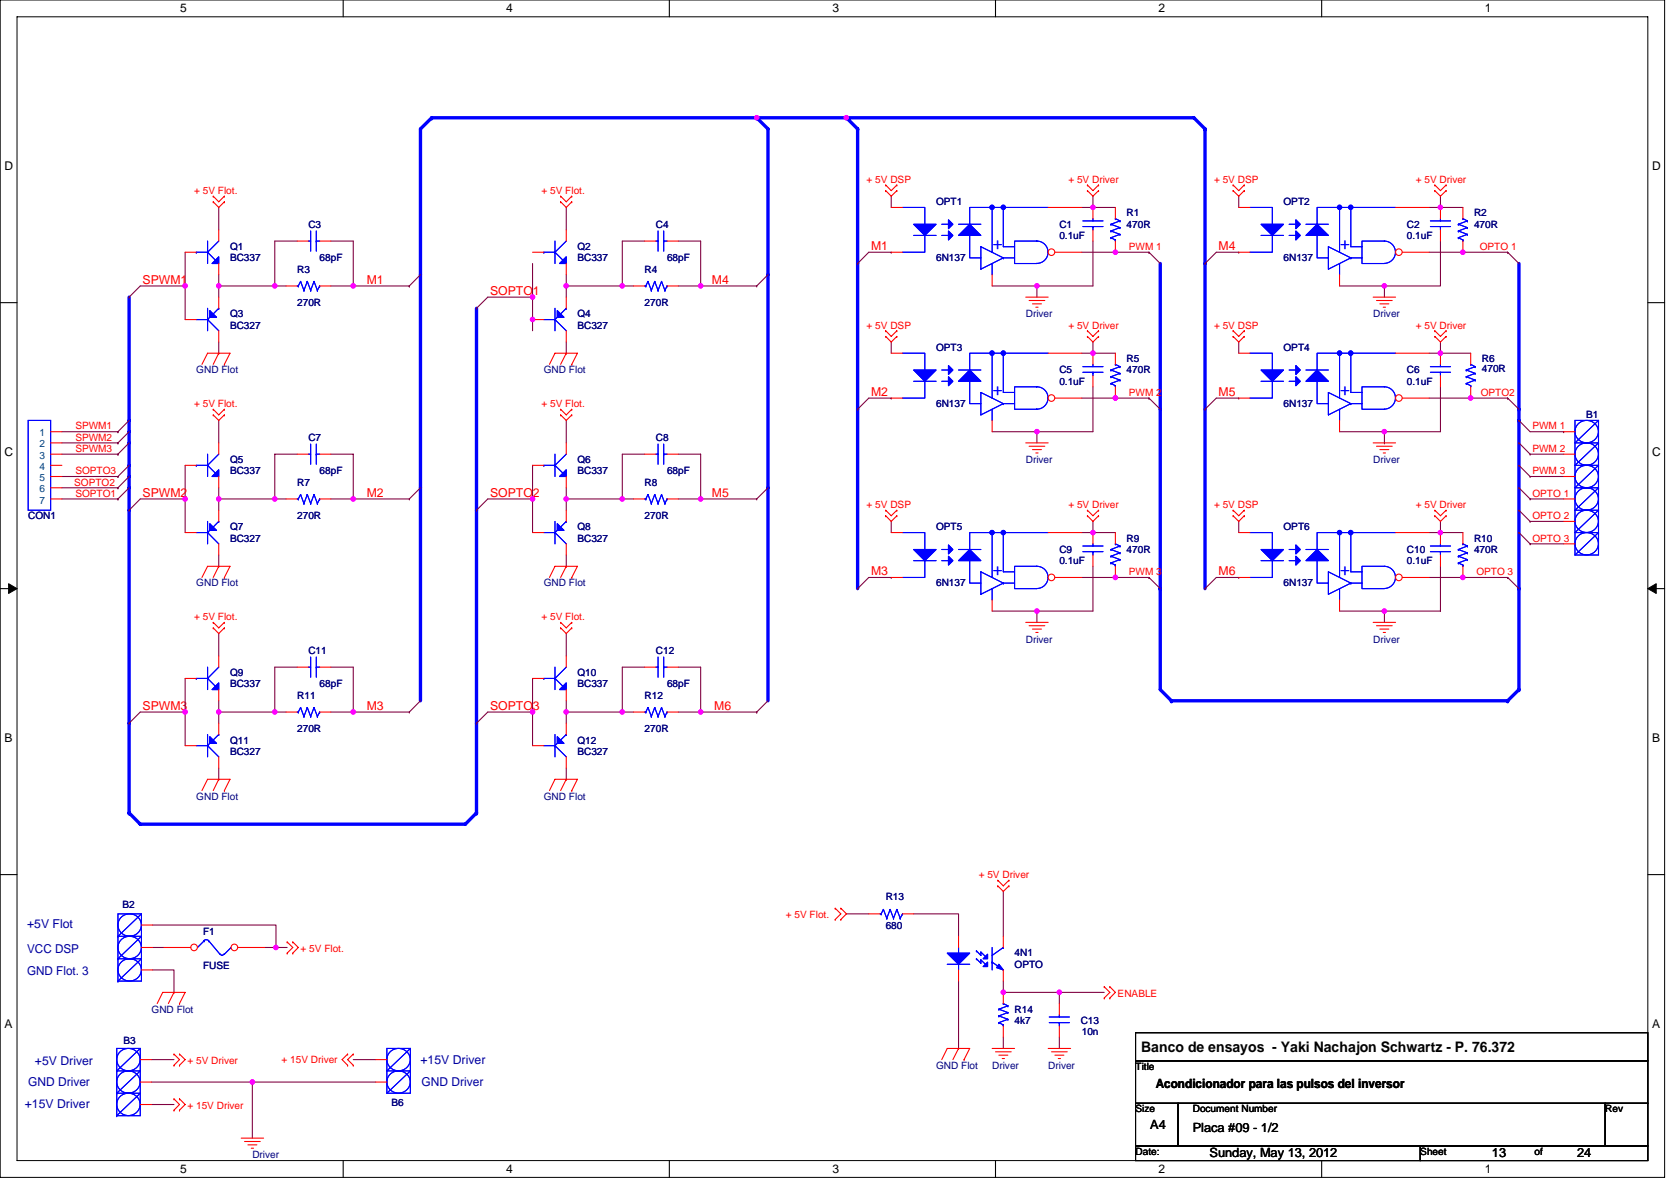
[picture p96: page 1]

Banco de ensayos - Yaki Nachajon Schwartz - P. 76.372

Title
Acondicionador para las pulsos del inversor

Size Size Size A4 A4 A4 | Document Number Document Number Document Number Placa #09 - 1/2 Placa #09 - 1/2 Placa #09 - 1/2 | Rev Rev Rev

Date: Date: Date: Sunday, May 13, 2012 Sunday, May 13, 2012 | Sheet Sheet Sheet 13 13 of of of 24 24
