Francisco89/tesis/Placa adquisidora/placa yaki/Placa 12 _ V  DCBUS - ISO124.pdf

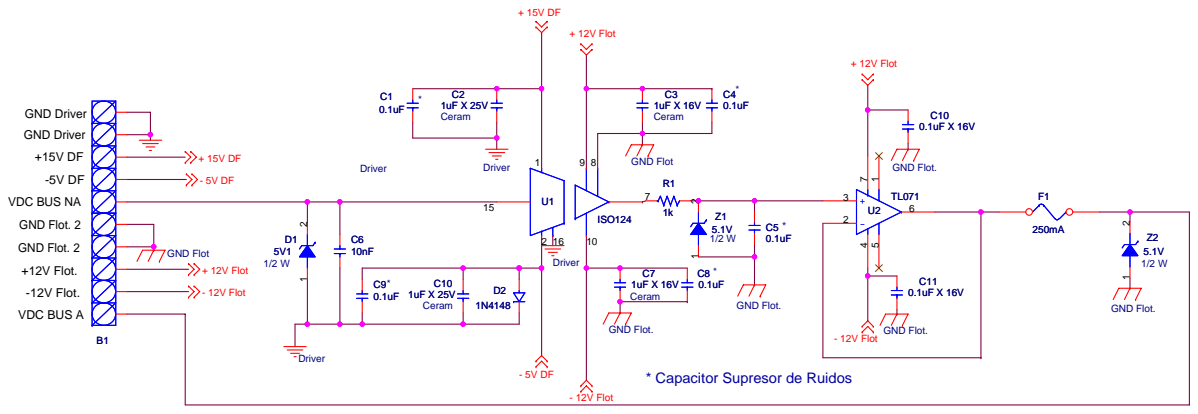
[picture p97: page 1]

* Capacitor Supresor de Ruidos

Banco de ensayos - Yaki Nachajon Schwartz - P. 76.372

Title
Acondicionador de la tensión del BCC (VDC BUS)

Size Size Size A4 A4 A4 | Document Number Document Number Document Number Placa #12 Placa #12 Placa #12 | Rev Rev Rev

Date: Date: Date: Sunday, May 13, 2012 Sunday, May 13, 2012 Sunday, May 13, 2012 | Sheet Sheet Sheet 17 17 17 of of of 24 24 24
