Francisco89/tesis/Placa adquisidora/Simulaciones/Filtro AntiAliasing/filtro ruido prueba.asc

C1: cap; 1n
C2: cap; 1n
C3: cap; 470p
C4: cap; 470p
C5: cap; 1n
C6: cap; 470p
C7: cap; 1n
C8: cap; 470p
C9: cap; 0.1µ
C10: cap; 0.1µ
C11: cap; 1n
C12: cap; 470p
I1: current; 1
R1: res; 10k
R2: res; 10k
R3: res; 10k
R4: res; 10k
R5: res; 10k
R6: res; 10k
R7: res; 10k
R8: res; 10k
R9: res; 10k
R10: res; 10k
R11: res; 10k
R12: res; 10k
R13: res; 10k
R14: res; 10k
R15: res; 10k
U1: opamp
U2: opamp
U3: opamp
U4: opamp
U6: opamp
V1: voltage; ""; AC 1
V2: voltage; 15
V3: voltage; 15
V4: voltage; ""; AC 1
V5: voltage; ""
V6: voltage; ""; AC 1
Named nets: 0, +15, -15, o2, i2, o1, i1, i3, i4, i5, o5, o4, o3
.lib opamp.sub
;ac dec 1000 1 150k
.noise V(o1) V1 dec 1000 10 125k
