Francisco89/tesis/Placa adquisidora/Simulaciones/Filtro AntiAliasing/filtro modelo ruido corriente.asc

In1: current
In+: current
In-: current
R1: res; 10k
R2: res; 10k
R3: res; 10k
Req: res; 10k
U1: tl074
U2: tl074
Named nets: +15, -15, 0, Salida
