Francisco89/tesis/Placa adquisidora/Simulaciones/Filtro AntiAliasing/filtro modelo ruido.asc

In+: current
In-: current
R1: res; 10k
R2: res; 10k
R3: res; 10k
Rs: res; 50
U1: tl074
Vn1: voltage
Vn2: voltage
Vn3: voltage
Vn: voltage
Vns: voltage
Named nets: +15, -15, 0, Salida
