Francisco89/tesis/Placa adquisidora/Simulaciones/Filtro AntiAliasing/filtro modelo ruidol.asc

C1: cap; 1.2n
C2: cap; 1n
C3: cap; 470p
C4: cap; 1.8n
C5: cap; 390p
C6: cap; 240p
C7: cap; 4.7n
C8: cap; 82p
C9: cap; 0.1µ
C10: cap; 0.1µ
C11: cap; 15p
C12: cap; 10pF
C13: cap; 15p
R1: res; 10k
R2: res; 10k
R3: res; 10k
R4: res; 10k
R5: res; 10k
R6: res; 10k
R7: res; 10k
R8: res; 10k
R9: res; 10k
R10: res; 10k
R11: res; 10k
R12: res; 10k
R13: res; 50
R14: res; 10Meg
R16: res; 10Meg
U1: tl074
U2: tl074
U3: tl074
U4: tl074
V1: voltage; ""; AC 1
V2: voltage; 15
V3: voltage; 15
Named nets: 0, tag, +15, -15
.lib opamp.sub
.ac dec 1000 1 150k
