Francisco89/tesis/Placa adquisidora/Simulaciones/Filtro AntiAliasing/filtro nominal 1%.asc

C1: cap; 13n
C2: cap; 2.4n
C3: cap; 1n
C5: cap; 1n
R1: res; 2.94k
R2: res; 1.47k
R3: res; 1.21k
R4: res; 2.94k
R5: res; 604
R6: res; 1.21k
U1: opamp
U2: opamp
V1: voltage; ""; AC 1
Named nets: 0
.lib opamp.sub
.ac dec 1000 0.1 1Meg
