Francisco89/tesis/Placa adquisidora/Simulaciones/Filtro AntiAliasing/filtro nominal 5% - medicion de corriente.asc

C1: cap; 13n
C2: cap; 2.4n
C3: cap; 1n
C5: cap; 1n
R1: res; 3k
R2: res; 1.5k
R3: res; 1.2k
R4: res; 3k
R5: res; 620
R6: res; 1.2k
U1: tl074
U2: tl074
V1: voltage; SINE(0 1 100); AC 1
V2: voltage; 15
V3: voltage; 15
Named nets: 0, 15, -15
.lib opamp.sub
;ac dec 1000 0.1 1Meg
.tran 1
