Francisco89/tesis/Placa adquisidora/Simulaciones/Filtro AntiAliasing/filtro ruido i1.asc

C2: cap; 1n
C3: cap; 470p
R1: res; 10k
R2: res; 10k
R4: res; 10k
U1: opamp
V1: voltage; 0
Named nets: 0, o1, i1
.lib opamp.sub
.noise V(i1) V1 dec 1000 10 125k
