Francisco89/tesis/Placa adquisidora/Simulaciones/Filtro AntiAliasing/filtro ruido i2.asc

C2: cap; 1n
C3: cap; 470p
R1: res; 10k
R2: res; 10k
R4: res; 10k
U1: opamp
V2: voltage; ""
Named nets: 0, o2, i2
.lib opamp.sub
.noise V(i2) V2 dec 1000 10 125k
