Francisco89/tesis/Placa adquisidora/Simulaciones/Filtro AntiAliasing/filtro ruido i3.asc

C5: cap; 1n
C6: cap; 470p
R7: res; 10k
R8: res; 10k
R9: res; 10k
U3: tl074
V3: voltage; ""
Named nets: 0, +15, -15, i3, o3
.noise V(i3) V3 dec 1000 10 125k
