Francisco89/tesis/Placa adquisidora/Simulaciones/Filtro AntiAliasing/filtro ruido i4.asc

C7: cap; 1n
C8: cap; 470p
R10: res; 10k
R11: res; 10k
R12: res; 10k
U1: opamp
V4: voltage; ""
Named nets: 0, i4, o4
.noise V(i4) V4 dec 1000 10 125k
.lib opamp.sub
