Francisco89/tesis/Placa adquisidora/Simulaciones/Filtro AntiAliasing/filtro ruido i5.asc

C11: cap; 1n
C12: cap; 470p
R14: res; 15k
U5: tl074
V5: voltage; ""
Named nets: 0, +15, -15, i5, o5
.lib opamp.sub
.noise V(i5) V5 dec 1000 10 125k
