Francisco89/tesis/(list of files, drawings)

Other design files:
Placa adquisidora/placa yaki/ACONDICIONADORES_PA.DSN
Placa adquisidora/placa yaki/acondicionadores_pa.opj
