Francisco89/tesis/Placa adquisidora/Esquematicos/canal filtro/filtro.kicad_pcb

## KiCad design Placa adquisidora/Esquematicos/canal filtro/filtro.kicad_pcb (2014-04-21)

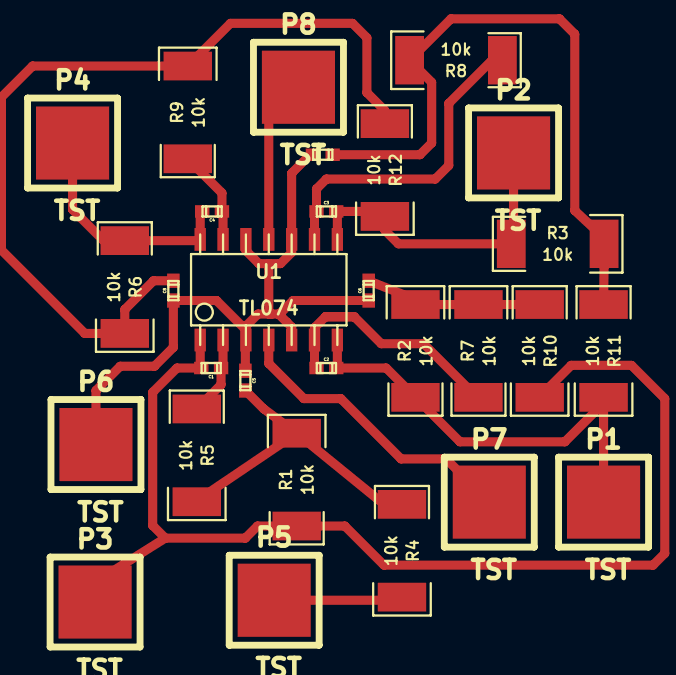
[picture p98: board filtro.kicad_pcb from above]

Board: 2 copper layers, 29 parts (0 on the bottom side), 16 nets.

Parts:
C1: 412pF; c_0402
C2: 357pF; c_0402
C3: 237pF; c_0402
C4: 82.5pF; c_0402
C5: 976pF; c_0402
C6: 1.15nF; c_0402
C7: 1.74nF; c_0402
C8: 4.87nF; c_0402
P1, P2, P3, P4, P5, P6, P7, P8: TST; 1PIN_SMD
R1, R2, R3, R4, R5, R6, R7, R8, R9, R10, R11, R12: 10k; r_2010
U1: TL074; so-14

Connections:
AGND: C5.2, C6.2, C7.2, C8.2, P6.1, U1.3, U1.5, U1.10, U1.12
unnamed: C1.2, R5.2, U1.2
unnamed: C2.2, R7.2, U1.6
unnamed: C3.1, P2.1, R3.2, R12.1, U1.8
unnamed: C4.2, R9.2, U1.13
unnamed: C1.1, P3.1, R1.2, R10.1, U1.1
unnamed: C2.1, P1.1, R2.2, R11.1, U1.7
unnamed: C3.2, R8.2, U1.9
unnamed: C7.1, R3.1, R8.1, R11.2
unnamed: C8.1, R6.1, R9.1, R12.2
unnamed: C5.1, R1.1, R4.2, R5.1
unnamed: C6.1, R2.1, R7.1, R10.2
unnamed: P5.1, R4.1
unnamed: C4.1, P4.1, R6.2, U1.14
VCC: P7.1, U1.4
VSS: P8.1, U1.11
