Francisco89/tesis/Placa adquisidora/Esquematicos/aislacion optica/salida.kicad_pcb

## KiCad design Placa adquisidora/Esquematicos/aislacion optica/salida.kicad_pcb (2014-04-21)

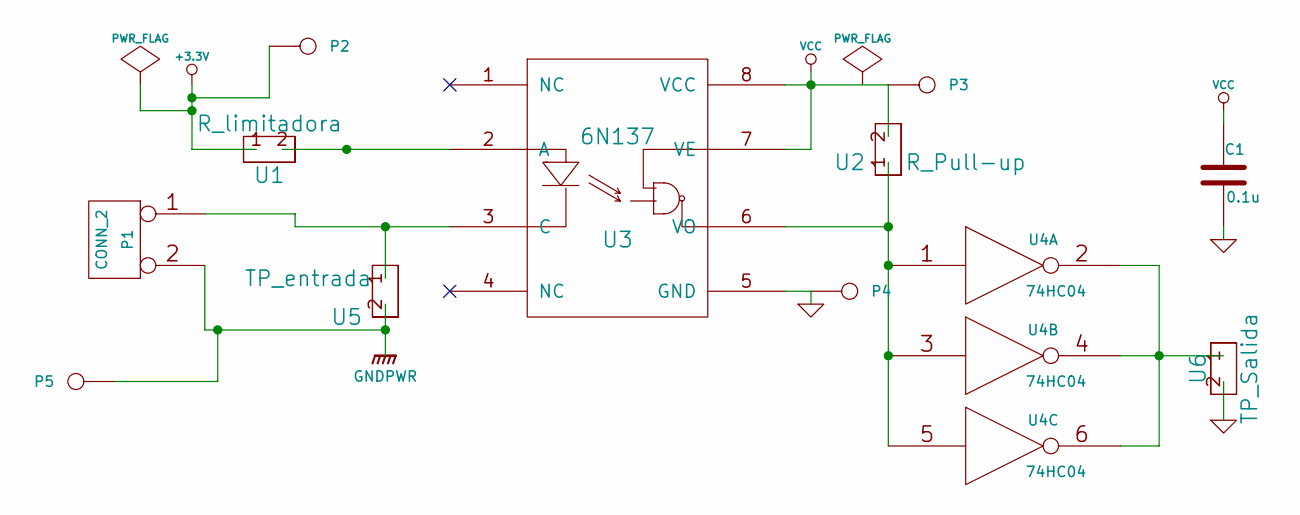
[picture p99: schematic salida.sch, noname.sch]

Parts:
C1: 0.1u
P1: CONN_2
P2, P3, P4, P5: CONN_1
U1: R_limitadora
U2: R_Pull-up
U3: 6N137
U4: 74HC04
U5: TP_entrada
U6: TP_Salida

Connections:
+3.3V: P2.1, U1.1
GND: C1.2, P4.1, U3.5 (GND), U4.7 (GND), U6.2
GNDPWR: P1.2 (PM), P5.1, U5.2
unnamed: U1.2, U3.2 (A)
unnamed: P1.1, U3.3 (C), U5.1
unnamed: U4.2, U4.4, U4.6, U6.1
unnamed: U2.1, U3.6 (VO), U4.1, U4.3, U4.5
VCC: C1.1, P3.1, U2.2, U3.7 (VE), U3.8 (VCC), U4.14 (VCC)

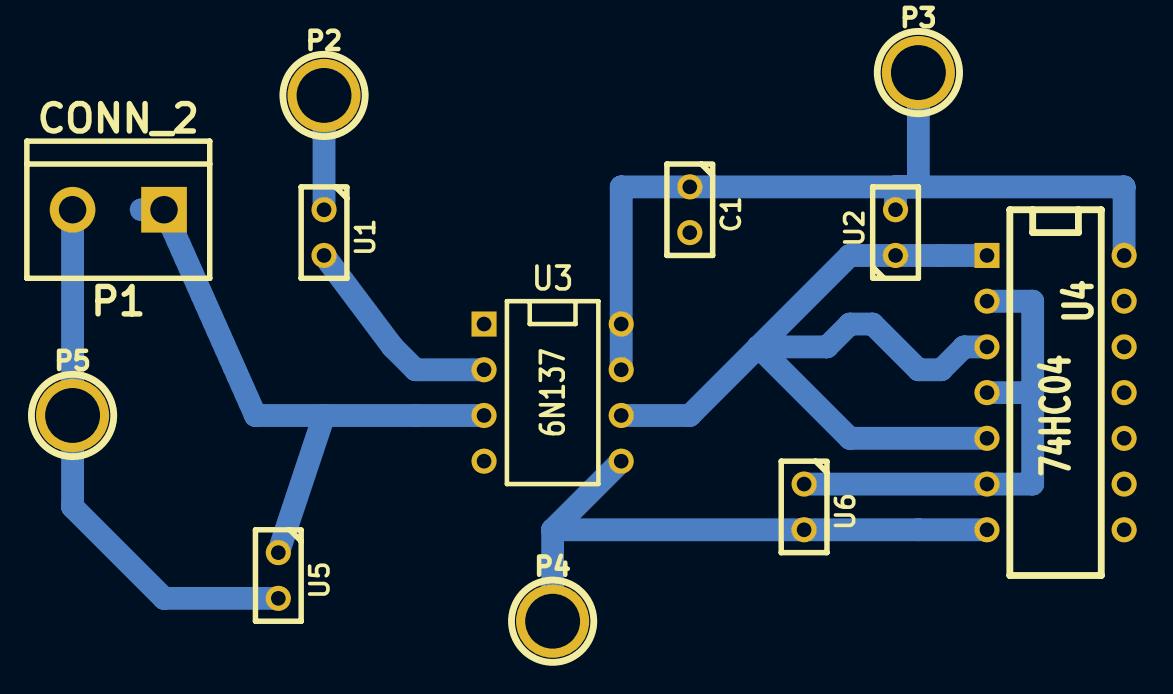
[picture p100: board salida.kicad_pcb from above]

Board: 2 copper layers, 12 parts (0 on the bottom side), 8 nets.
