Francisco89/tesis/Placa adquisidora/Esquematicos/aislacion optica/entrada.kicad_pcb

## KiCad design Placa adquisidora/Esquematicos/aislacion optica/entrada.kicad_pcb (2014-04-21)

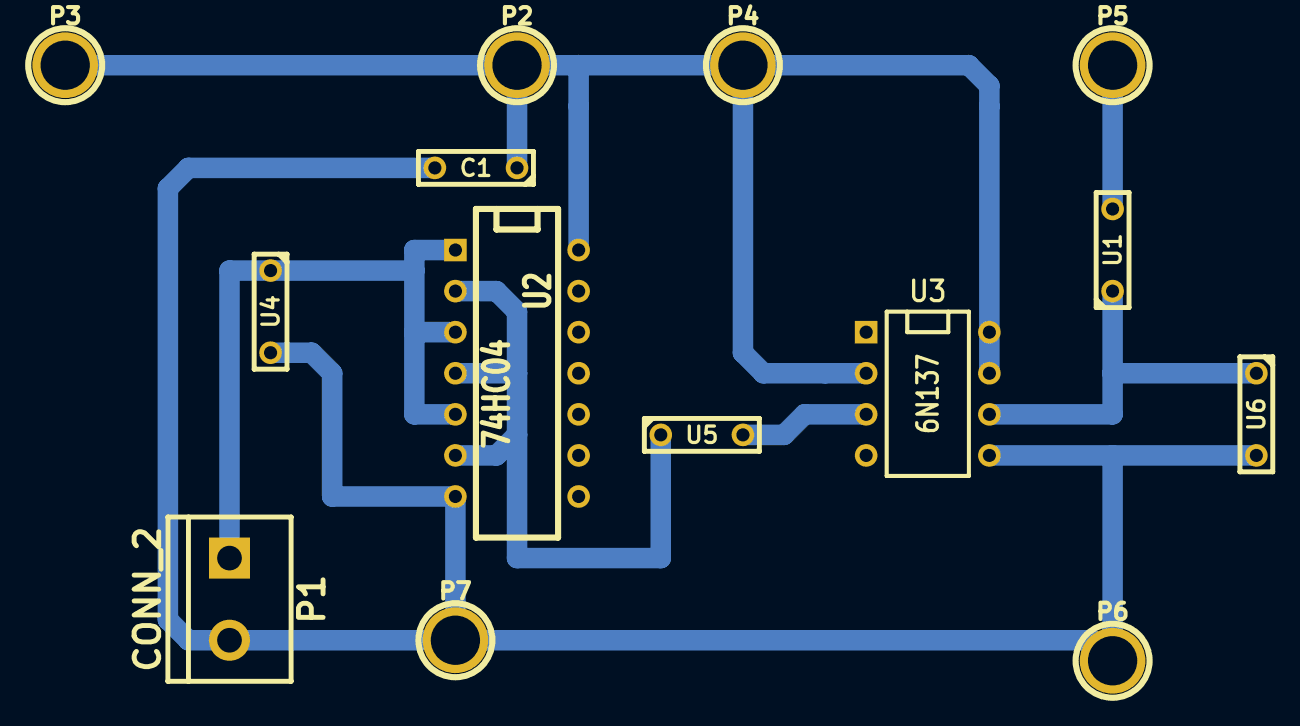
[picture p101: board entrada.kicad_pcb from above]

Board: 2 copper layers, 14 parts (0 on the bottom side), 7 nets.

Parts:
C1: 0.1u; C2
P1: CONN_2; bornier2
P2, P3, P4, P5, P6, P7: CONN_1; 1pin
U1: R_pull-up; C2
U2: 74HC04; DIP-14__300
U3: 6N137; DIP-8__300
U4: TP_entrada; C2
U5: R_limitadora; C2
U6: TP_salida; C2

Connections:
+3.3V: P5.1, U1.2
AGND: C1.2, P1.2, P6.1, P7.1, U2.7, U3.5, U4.2, U6.2
unnamed: U1.1, U3.6, U6.1
unnamed: U2.2, U2.4, U2.6, U5.1
unnamed: P1.1, U2.1, U2.3, U2.5, U4.1
unnamed: U3.3, U5.2
VAA: C1.1, P2.1, P3.1, P4.1, U2.14, U3.2, U3.7, U3.8
