Francisco89/tesis/Placa adquisidora/Esquematicos/aislacion optica/entrada_alternativa.kicad_pcb

## KiCad design Placa adquisidora/Esquematicos/aislacion optica/entrada_alternativa.kicad_pcb (2014-04-21)

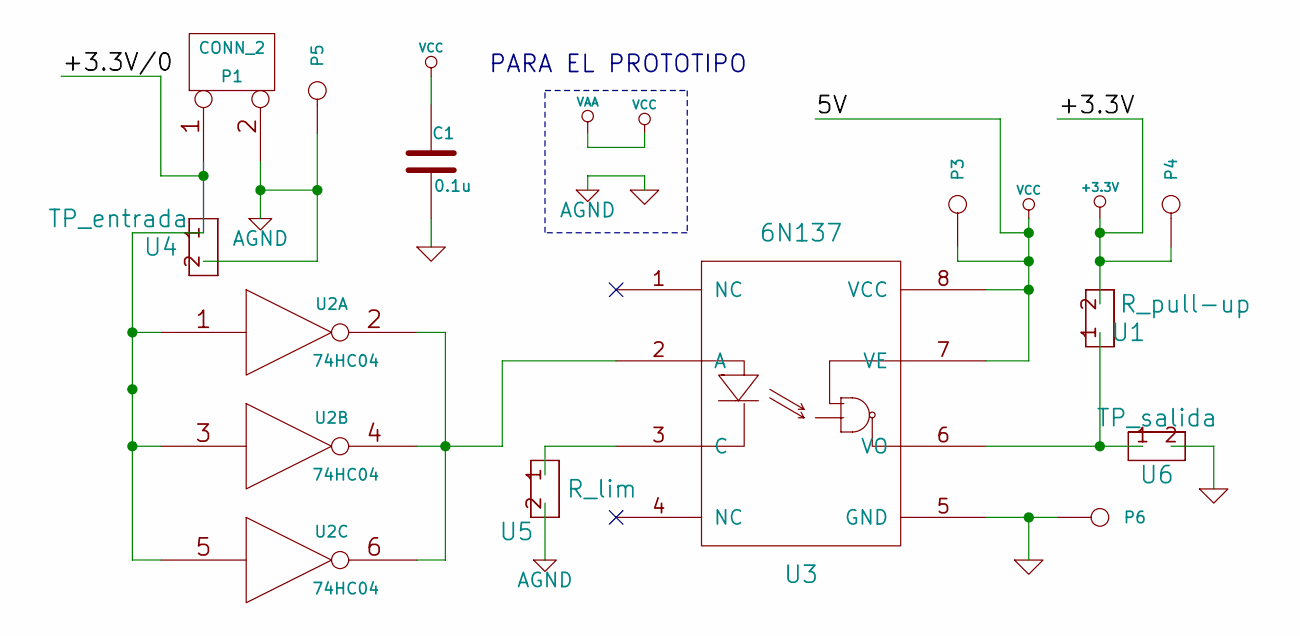
[picture p102: schematic entrada_alternativa.sch]

Parts:
C1: 0.1u
P1: CONN_2
P3, P4, P5, P6: CONN_1
U1: R_pull-up
U2: 74HC04
U3: 6N137
U4: TP_entrada
U5: R_lim
U6: TP_salida

Connections:
+3.3V: P4.1, U1.2
AGND: C1.2, P1.2 (PM), P5.1, P6.1, U2.7 (GND), U3.5 (GND), U4.2, U5.2, U6.2
unnamed: U1.1, U3.6 (VO), U6.1
unnamed: P1.1, U2.1, U2.3, U2.5, U4.1
unnamed: U2.2, U2.4, U2.6, U3.2 (A)
unnamed: U3.3 (C), U5.1
VAA: C1.1, P3.1, U2.14 (VCC), U3.7 (VE), U3.8 (VCC)

Notes on the sheet:
PARA EL PROTOTIPO

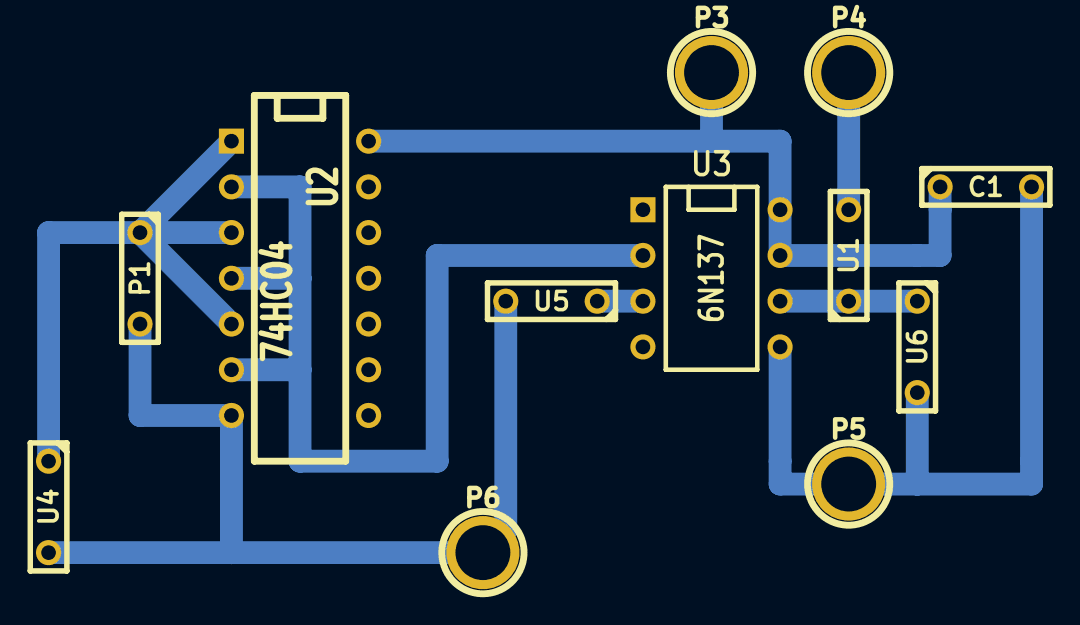
[picture p103: board entrada_alternativa.kicad_pcb from above]

Board: 2 copper layers, 12 parts (0 on the bottom side), 7 nets.
