Francisco89/tesis/Placa adquisidora/Esquematicos/Revs/050314/aislacion optica/aislacion optica.kicad_pcb

## KiCad design Placa adquisidora/Esquematicos/Revs/050314/aislacion optica/aislacion optica.kicad_pcb (2014-04-21)

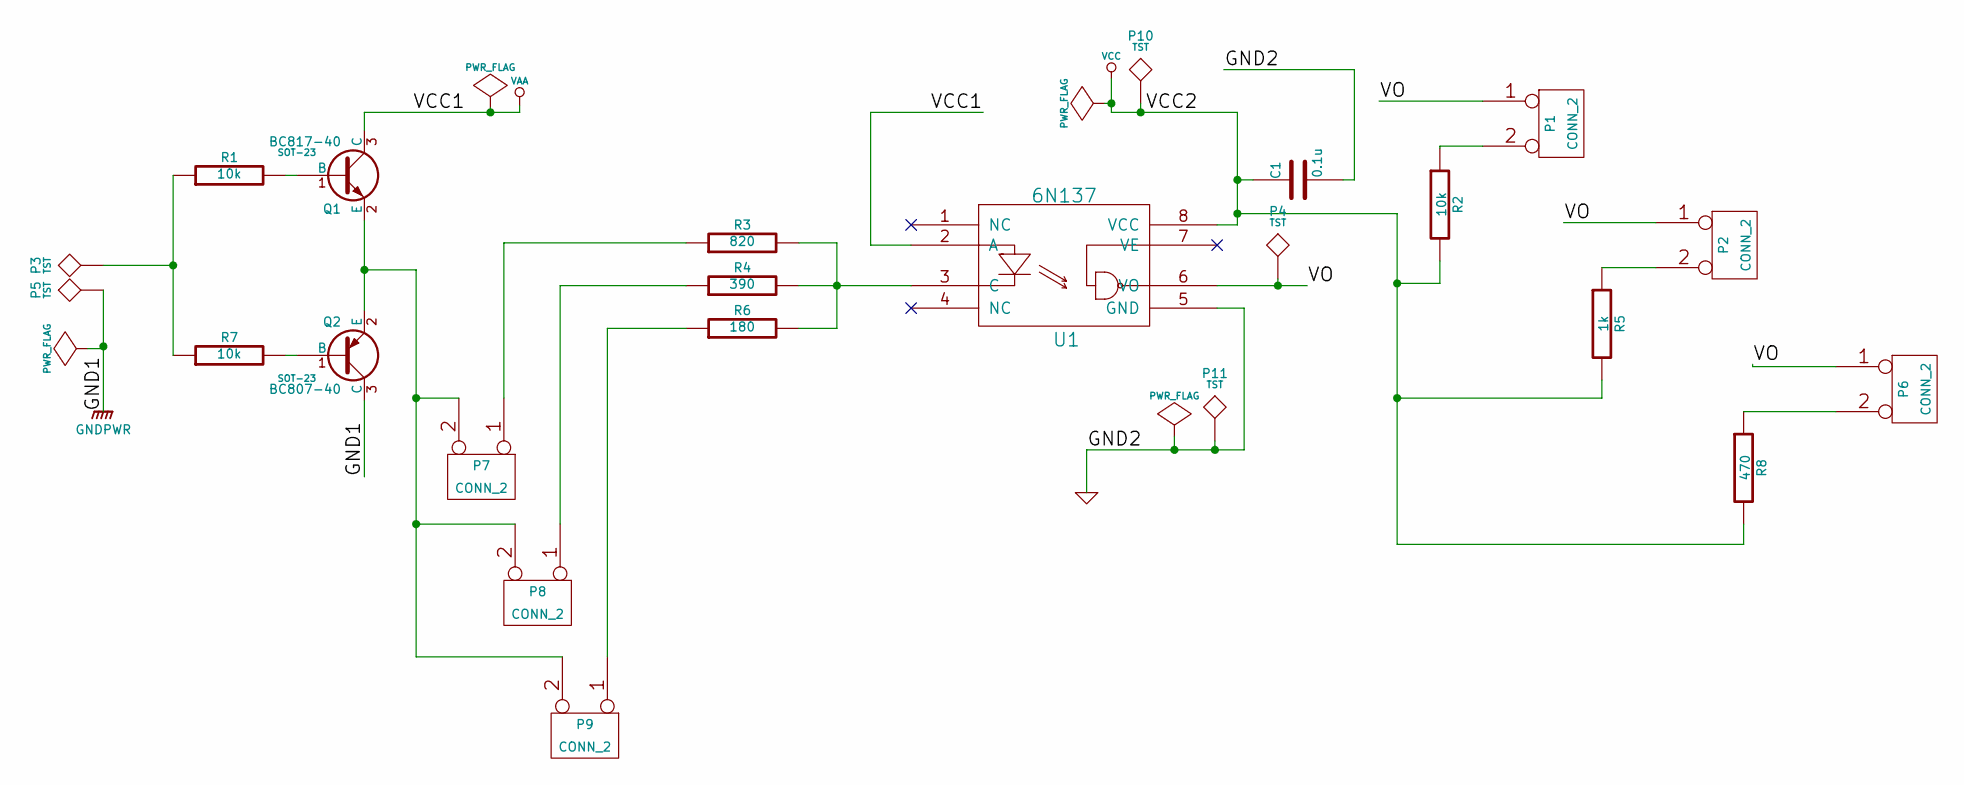
[picture p104: schematic aislacion optica.sch]

Parts:
C1: 0.1u
P1, P2, P6, P7, P8, P9: CONN_2
P3, P4, P5, P10, P11: TST
Q1: BC817-40; SOT-23
Q2: BC807-40; SOT-23
R1, R2, R7: 10k
R3: 820
R4: 390
R5: 1k
R6: 180
R8: 470
U1: 6N137

Connections:
/VO: P1.1, P2.1, P4.1, P6.1, U1.6 (VO)
GND: C1.2, P11.1, U1.5 (GND)
GNDPWR: P5.1, Q2.3 (C)
unnamed: Q2.1 (B), R7.2
unnamed: P3.1, R1.1, R7.1
unnamed: Q1.1 (B), R1.2
unnamed: P6.2 (PM), R8.1
unnamed: P2.2 (PM), R5.1
unnamed: P1.2 (PM), R2.1
unnamed: P7.2 (PM), P8.2 (PM), P9.2 (PM), Q1.2 (E), Q2.2 (E)
unnamed: P8.1, R4.1
unnamed: P7.1, R3.1
unnamed: P9.1, R6.1
unnamed: R3.2, R4.2, R6.2, U1.3 (C)
VAA: Q1.3 (C), U1.2 (A)
VCC: C1.1, P10.1, R2.2, R5.2, R8.2, U1.8 (VCC)

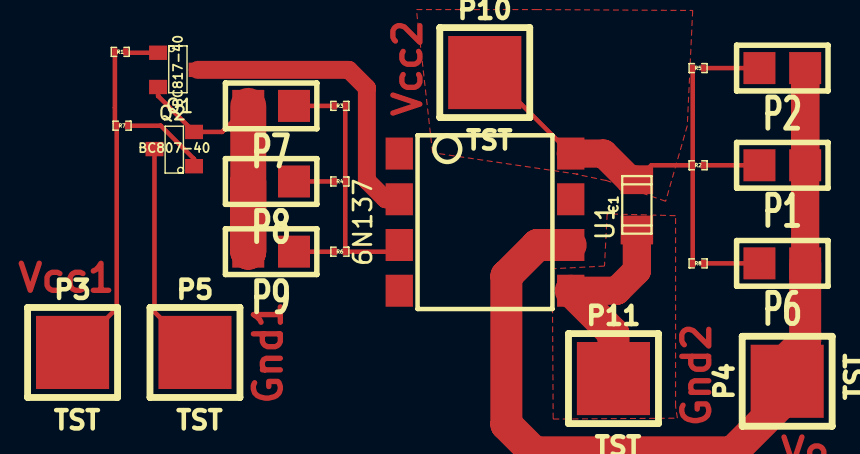
[picture p105: board aislacion optica.kicad_pcb from above]

Board: 2 copper layers, 23 parts (0 on the bottom side), 16 nets.
