Francisco89/tesis/Placa adquisidora/Esquematicos/fuentes/fuentes.kicad_pcb

## KiCad design Placa adquisidora/Esquematicos/fuentes/fuentes.kicad_pcb (2014-04-21)

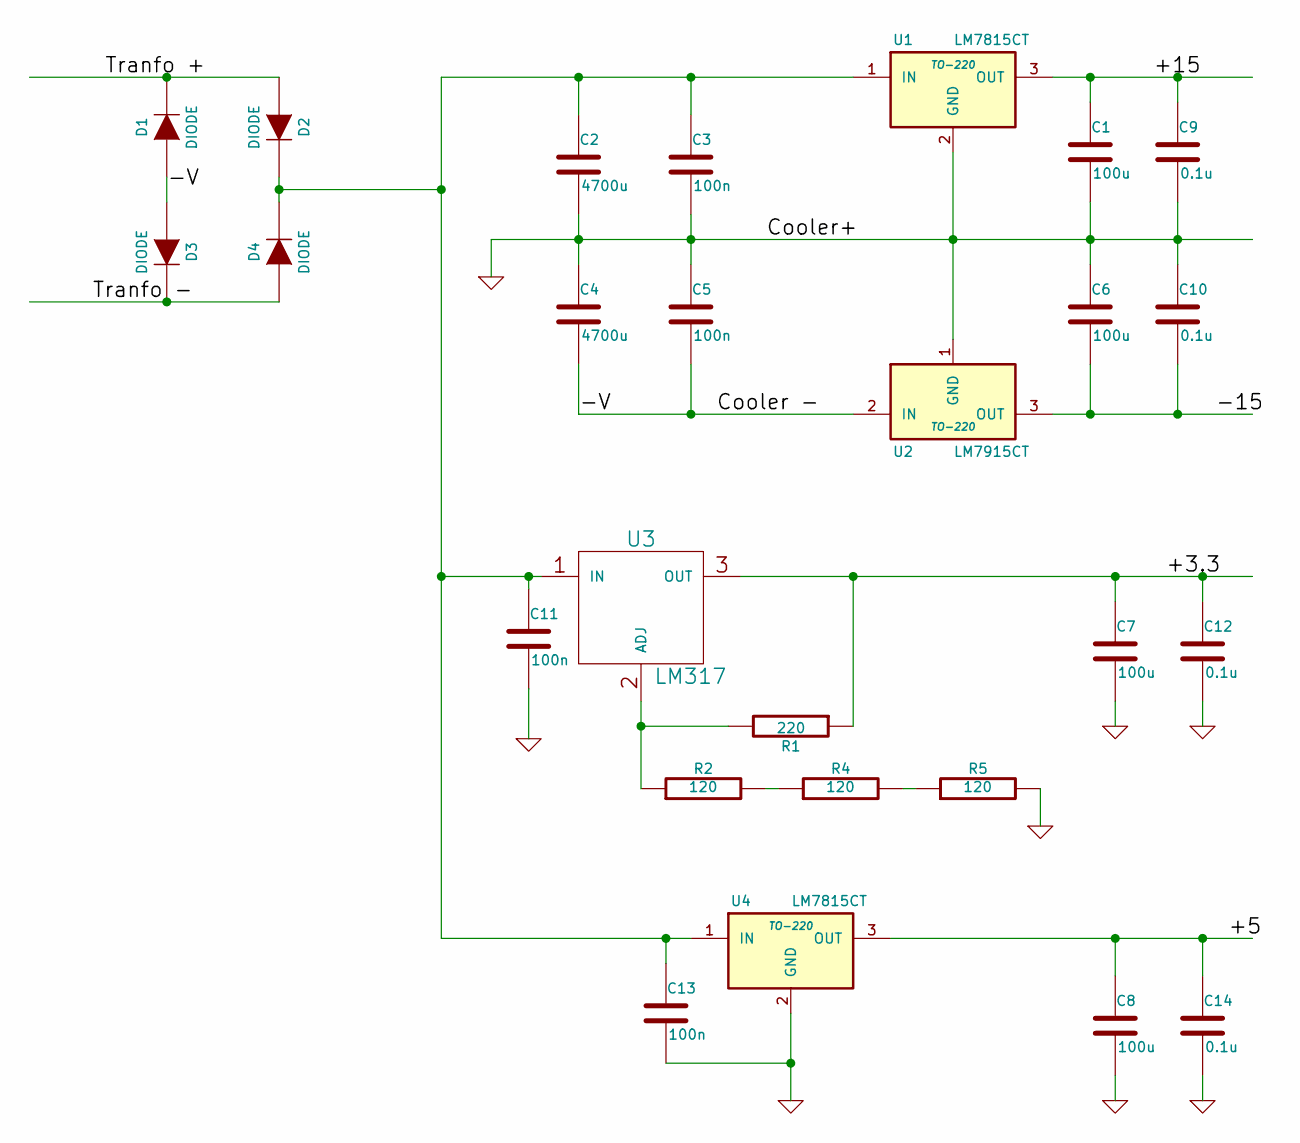
[picture p106: schematic fuentes.sch]

Parts:
C1, C6, C7, C8: 100u
C2, C4: 4700u
C3, C5, C11, C13: 100n
C9, C10, C12, C14: 0.1u
D1, D2, D3, D4: DIODE
R1: 220
R2, R4, R5: 120
U1, U4: LM7815CT; TO-220
U2: LM7915CT; TO-220
U3: LM317

Connections:
/+3.3: C7.1, C12.1, R1.1, U3.3 (OUT)
/+5: C8.1, C14.1, U4.3 (OUT)
/+15: C1.1, C9.1, U1.3 (OUT)
/-15: C6.2, C10.2, U2.3 (OUT)
/-V: C4.2, C5.2, D1.1 (A), D3.1 (A), U2.2 (IN)
/Tranfo +: D1.2 (K), D2.1 (A)
/Tranfo -: D3.2 (K), D4.1 (A)
GND: C1.2, C2.2, C3.2, C4.1, C5.1, C6.1, C7.2, C8.2, C9.2, C10.1, C11.2, C12.2, C13.2, C14.2, R5.2, U1.2 (GND), U2.1 (GND), U4.2 (GND)
unnamed: C2.1, C3.1, C11.1, C13.1, D2.2 (K), D4.2 (K), U1.1 (IN), U3.1 (IN), U4.1 (IN)
unnamed: R2.2, R4.1
unnamed: R1.2, R2.1, U3.2 (ADJ)
unnamed: R4.2, R5.1

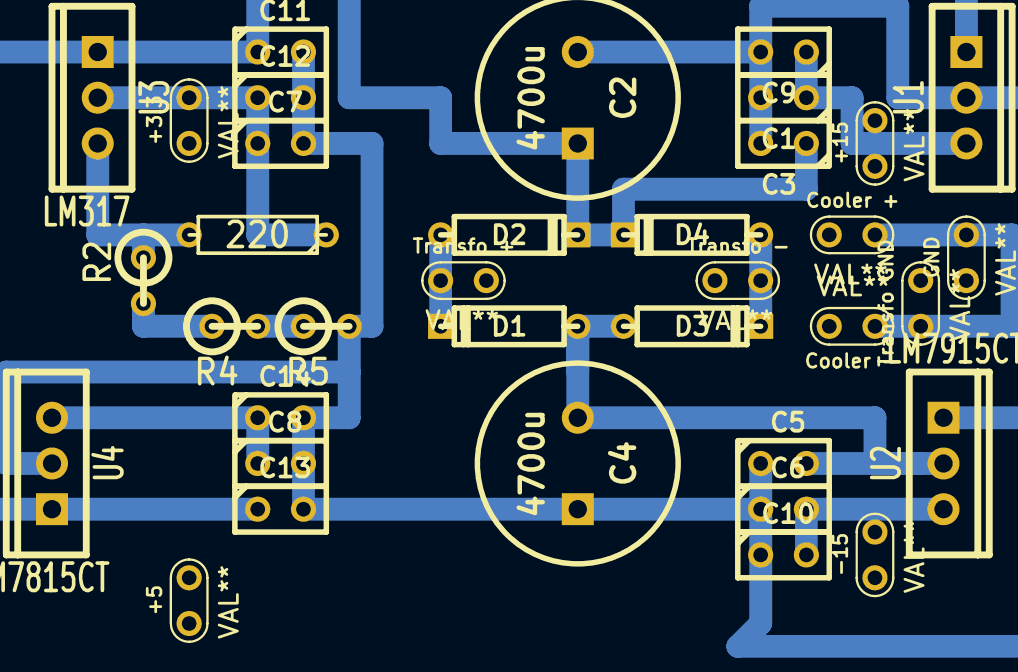
[picture p107: board fuentes.kicad_pcb from above]

Board: 2 copper layers, 36 parts (0 on the bottom side), 12 nets.

Other parts of the board:
+3.3, +5, +15: VAL**; TEST_POINT_2PADS
-15: VAL**; TEST_POINT_2PADS
Cooler +: VAL**; TEST_POINT_2PADS
Cooler -: VAL**; TEST_POINT_2PADS
GND: VAL**; TEST_POINT_2PADS
Transfo +: VAL**; TEST_POINT_2PADS
Transfo -: VAL**; TEST_POINT_2PADS
Transfo GND: VAL**; TEST_POINT_2PADS
