Francisco89/tesis/Placa adquisidora/Esquematicos/Revs/200214/adquisidora.sch

## KiCad design Placa adquisidora/Esquematicos/Revs/200214/adquisidora.sch (2014-04-21)

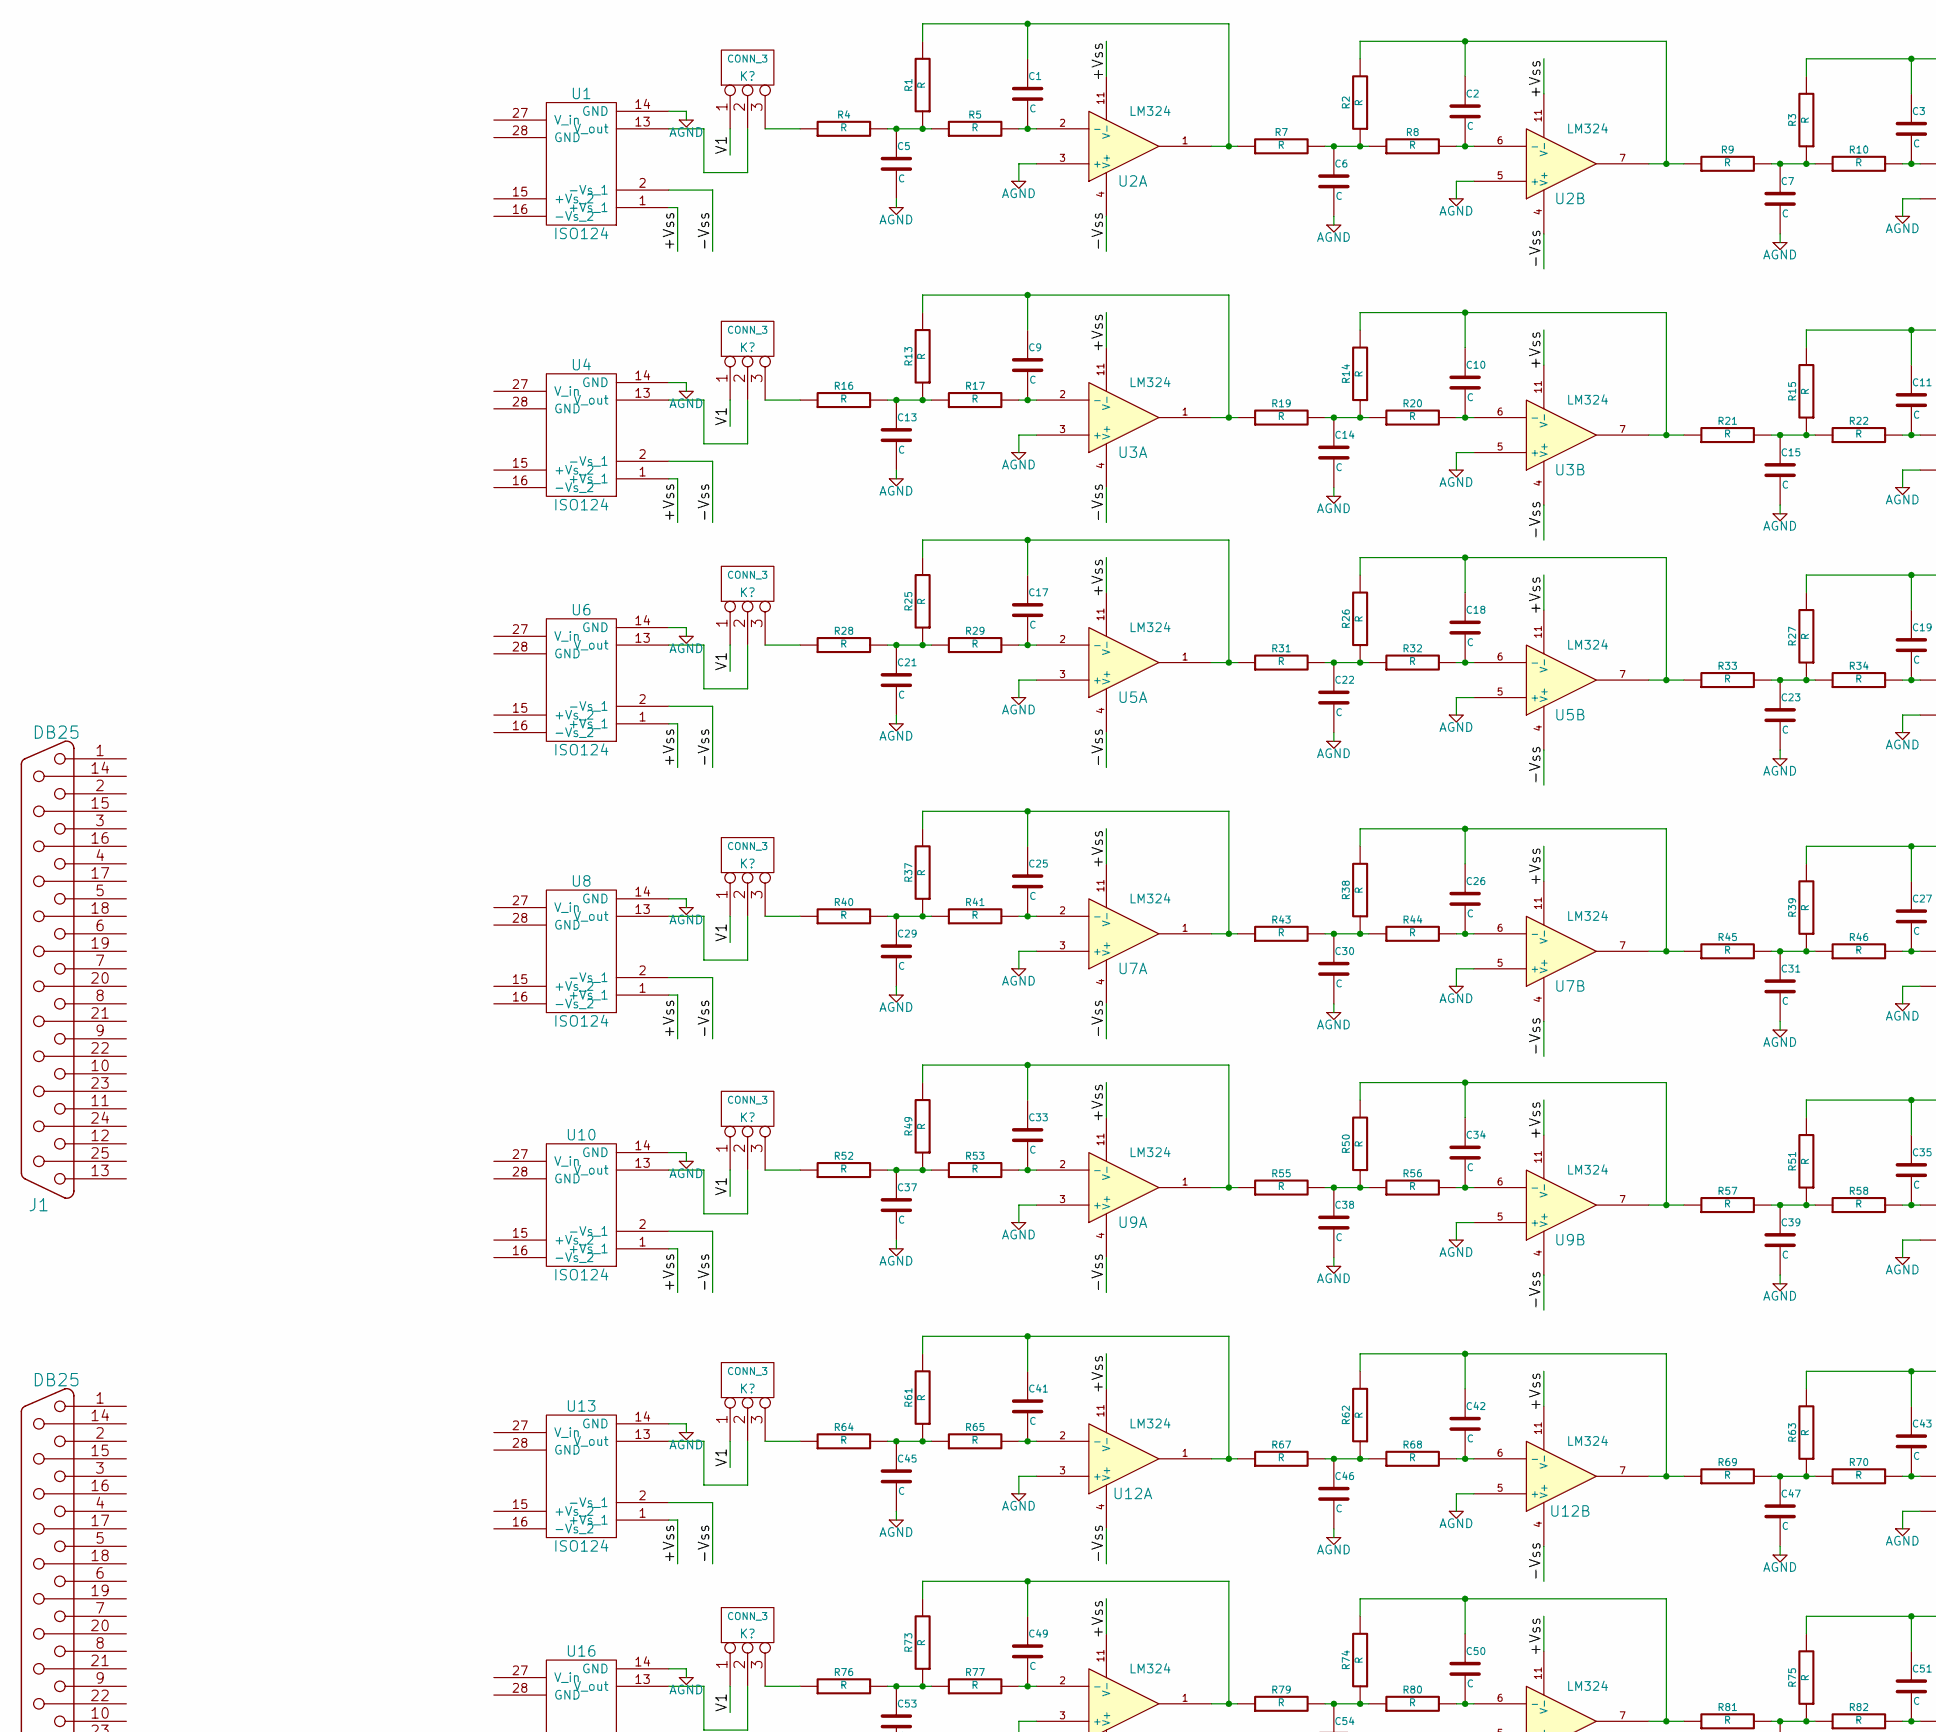
[picture p108: schematic adquisidora.sch, part in row 1, column 1]

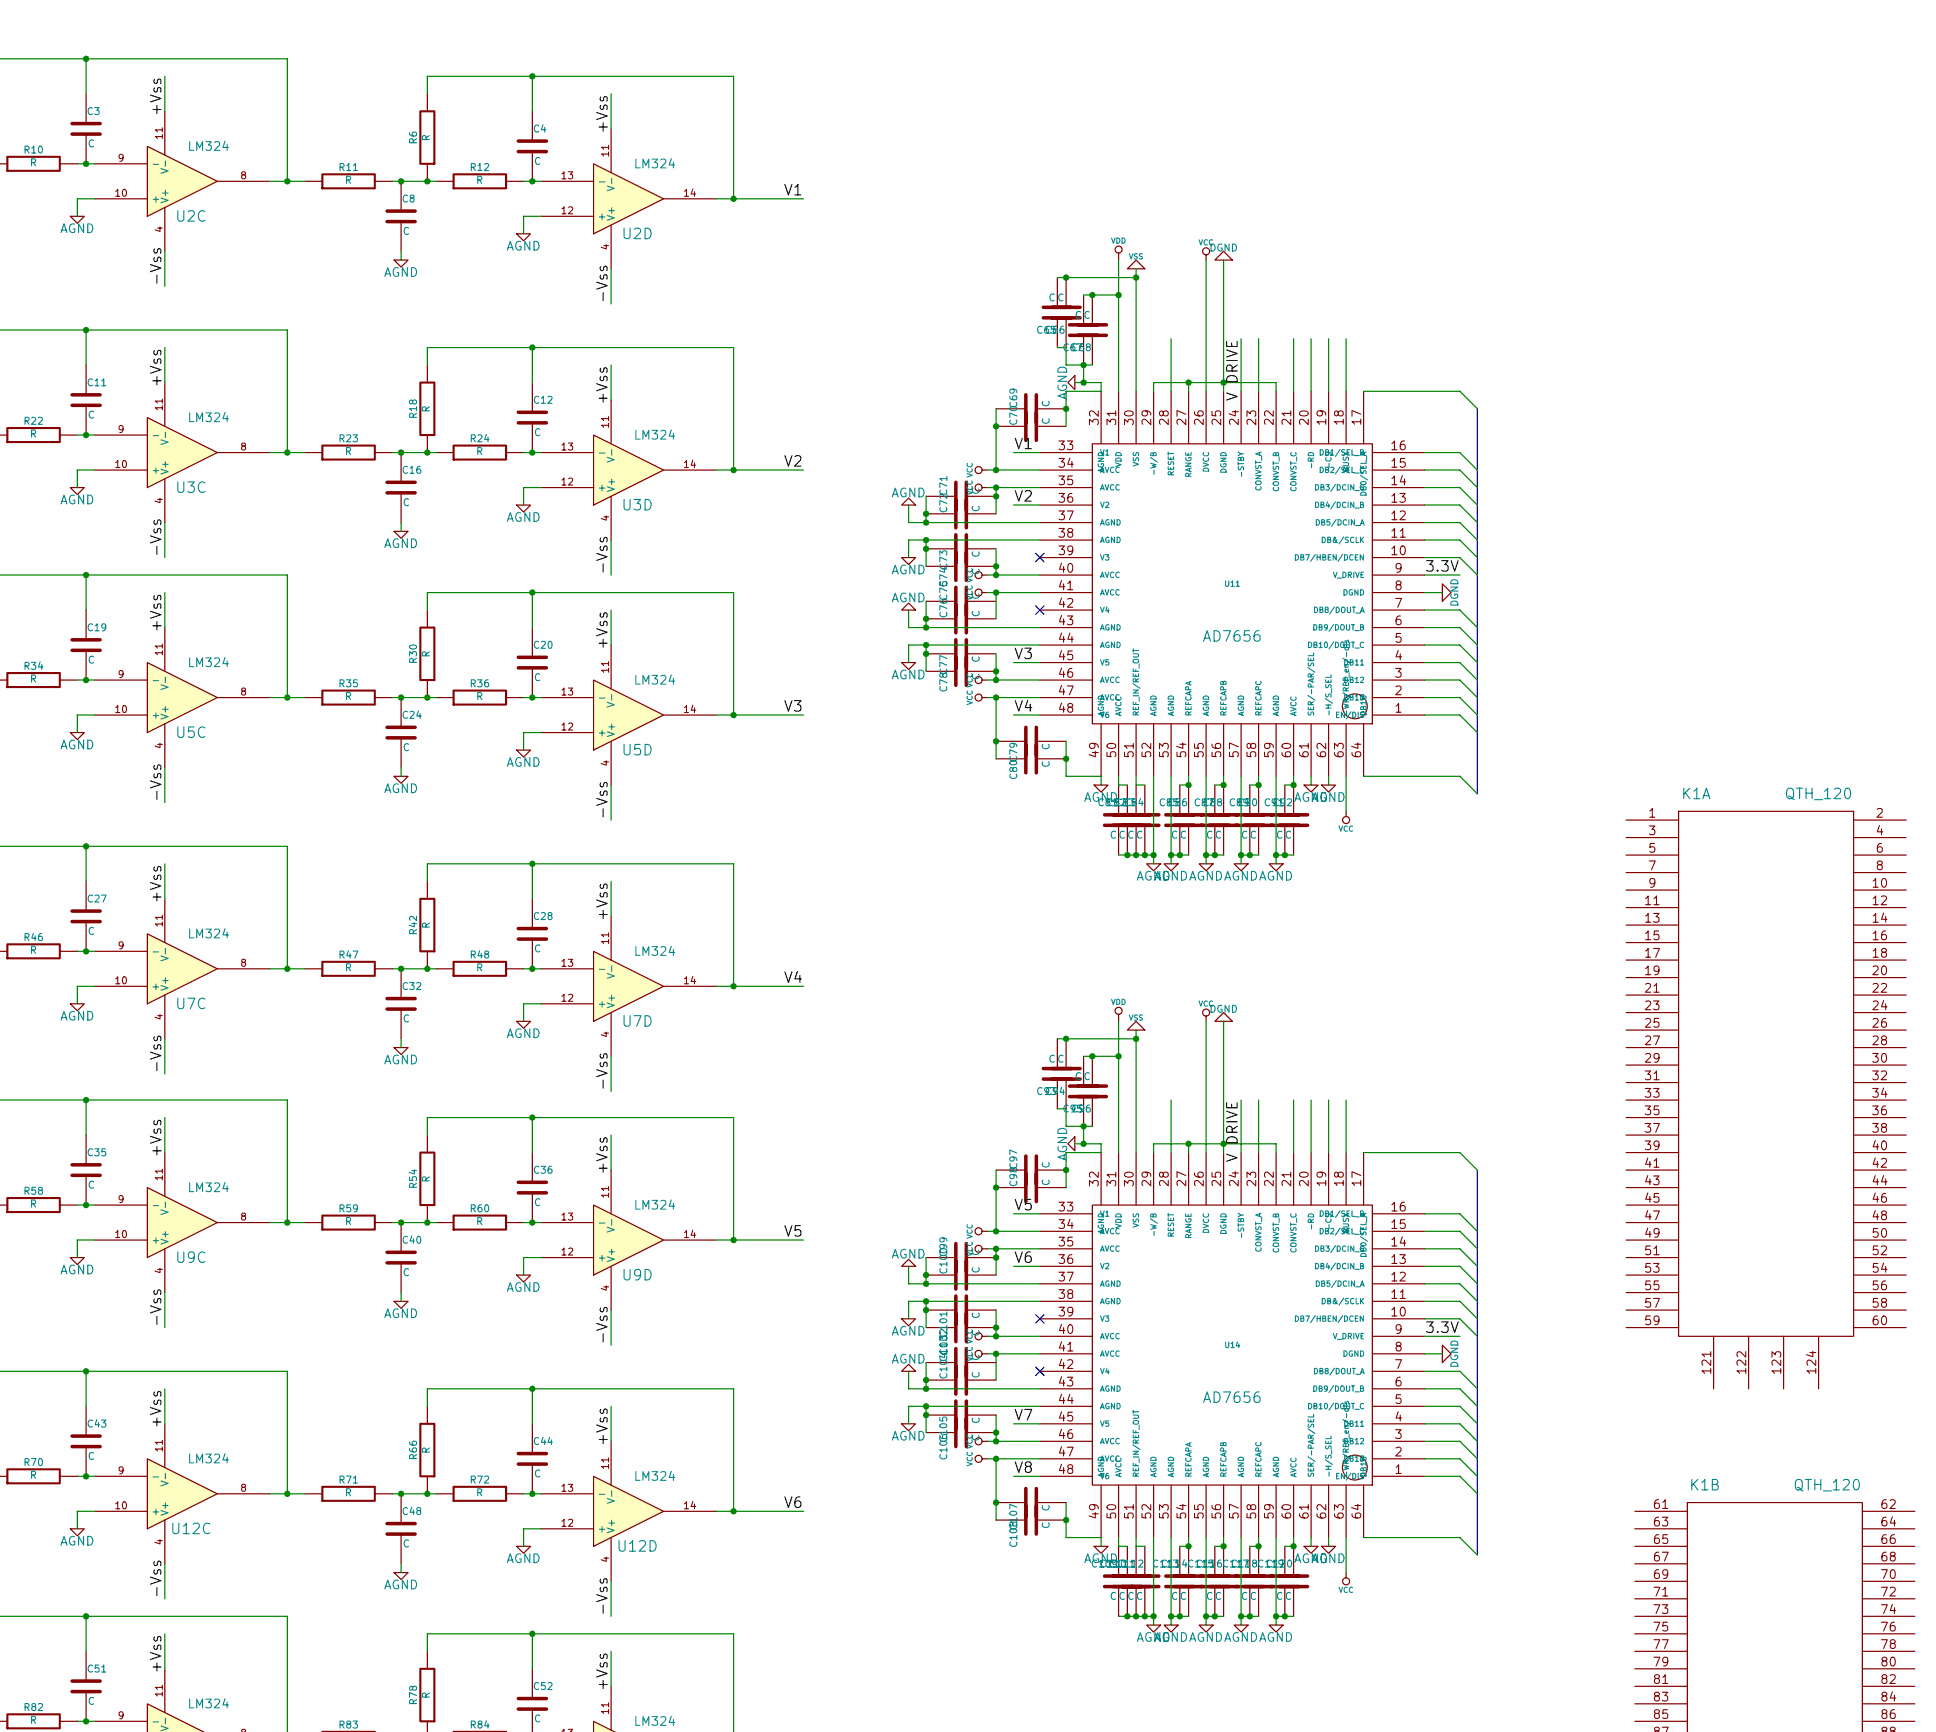
[picture p109: schematic adquisidora.sch, part in row 1, column 2]

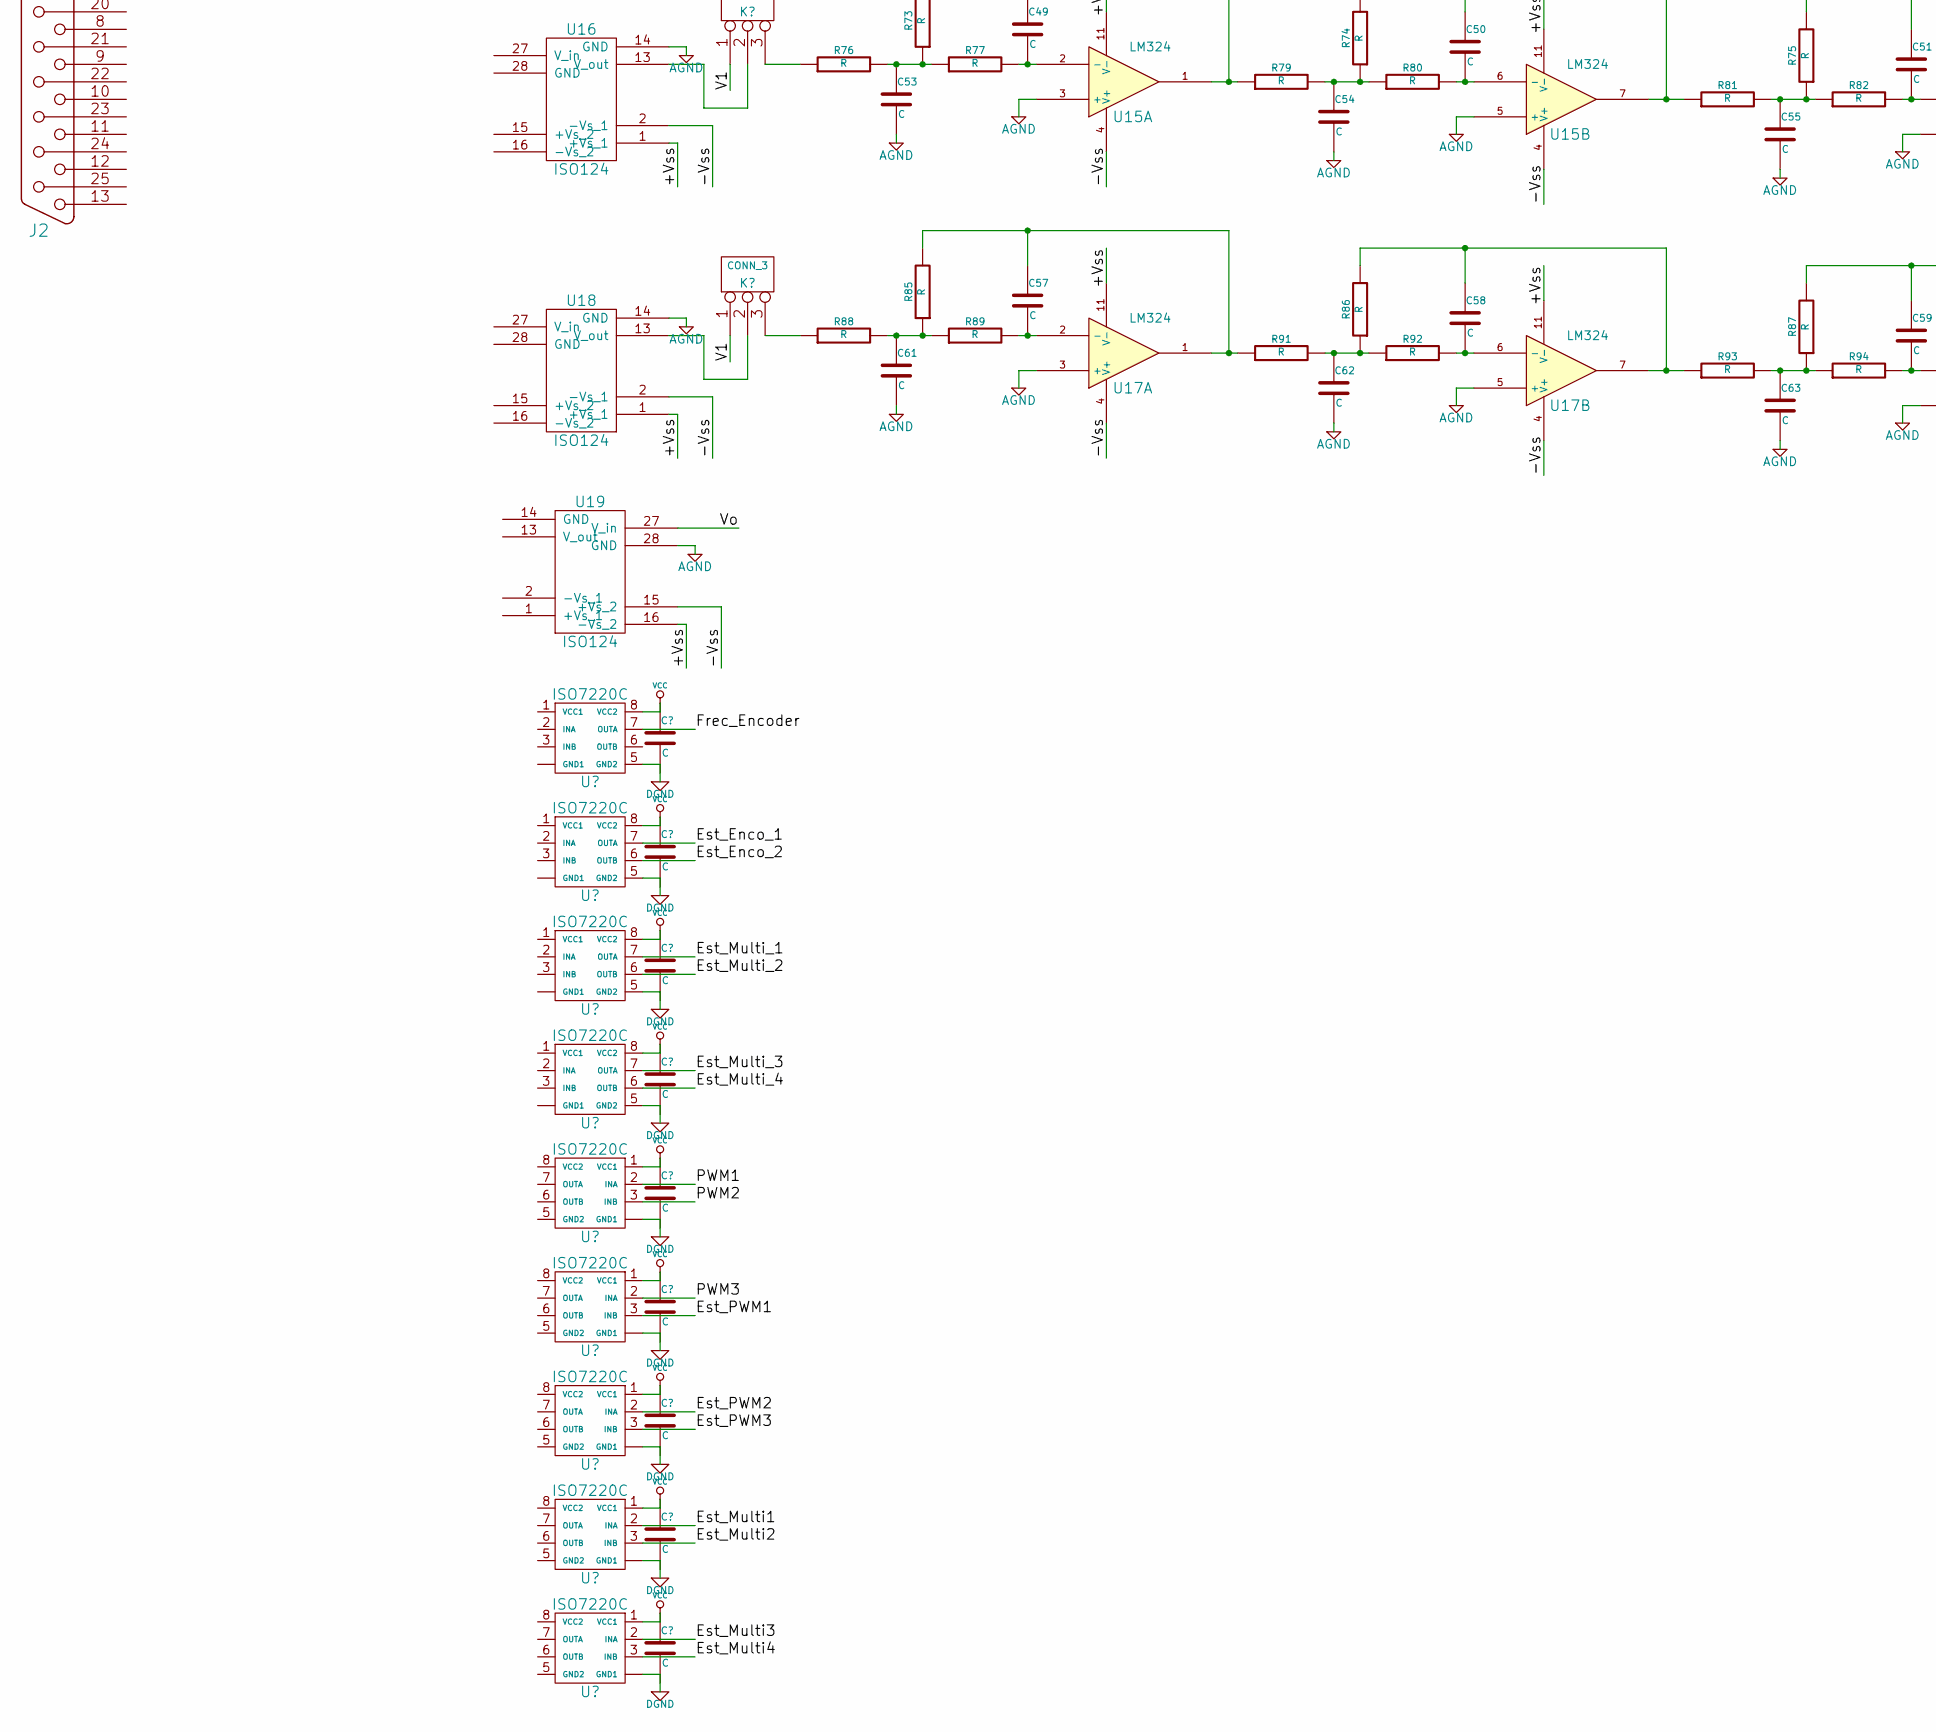
[picture p110: schematic adquisidora.sch, part in row 2, column 1]

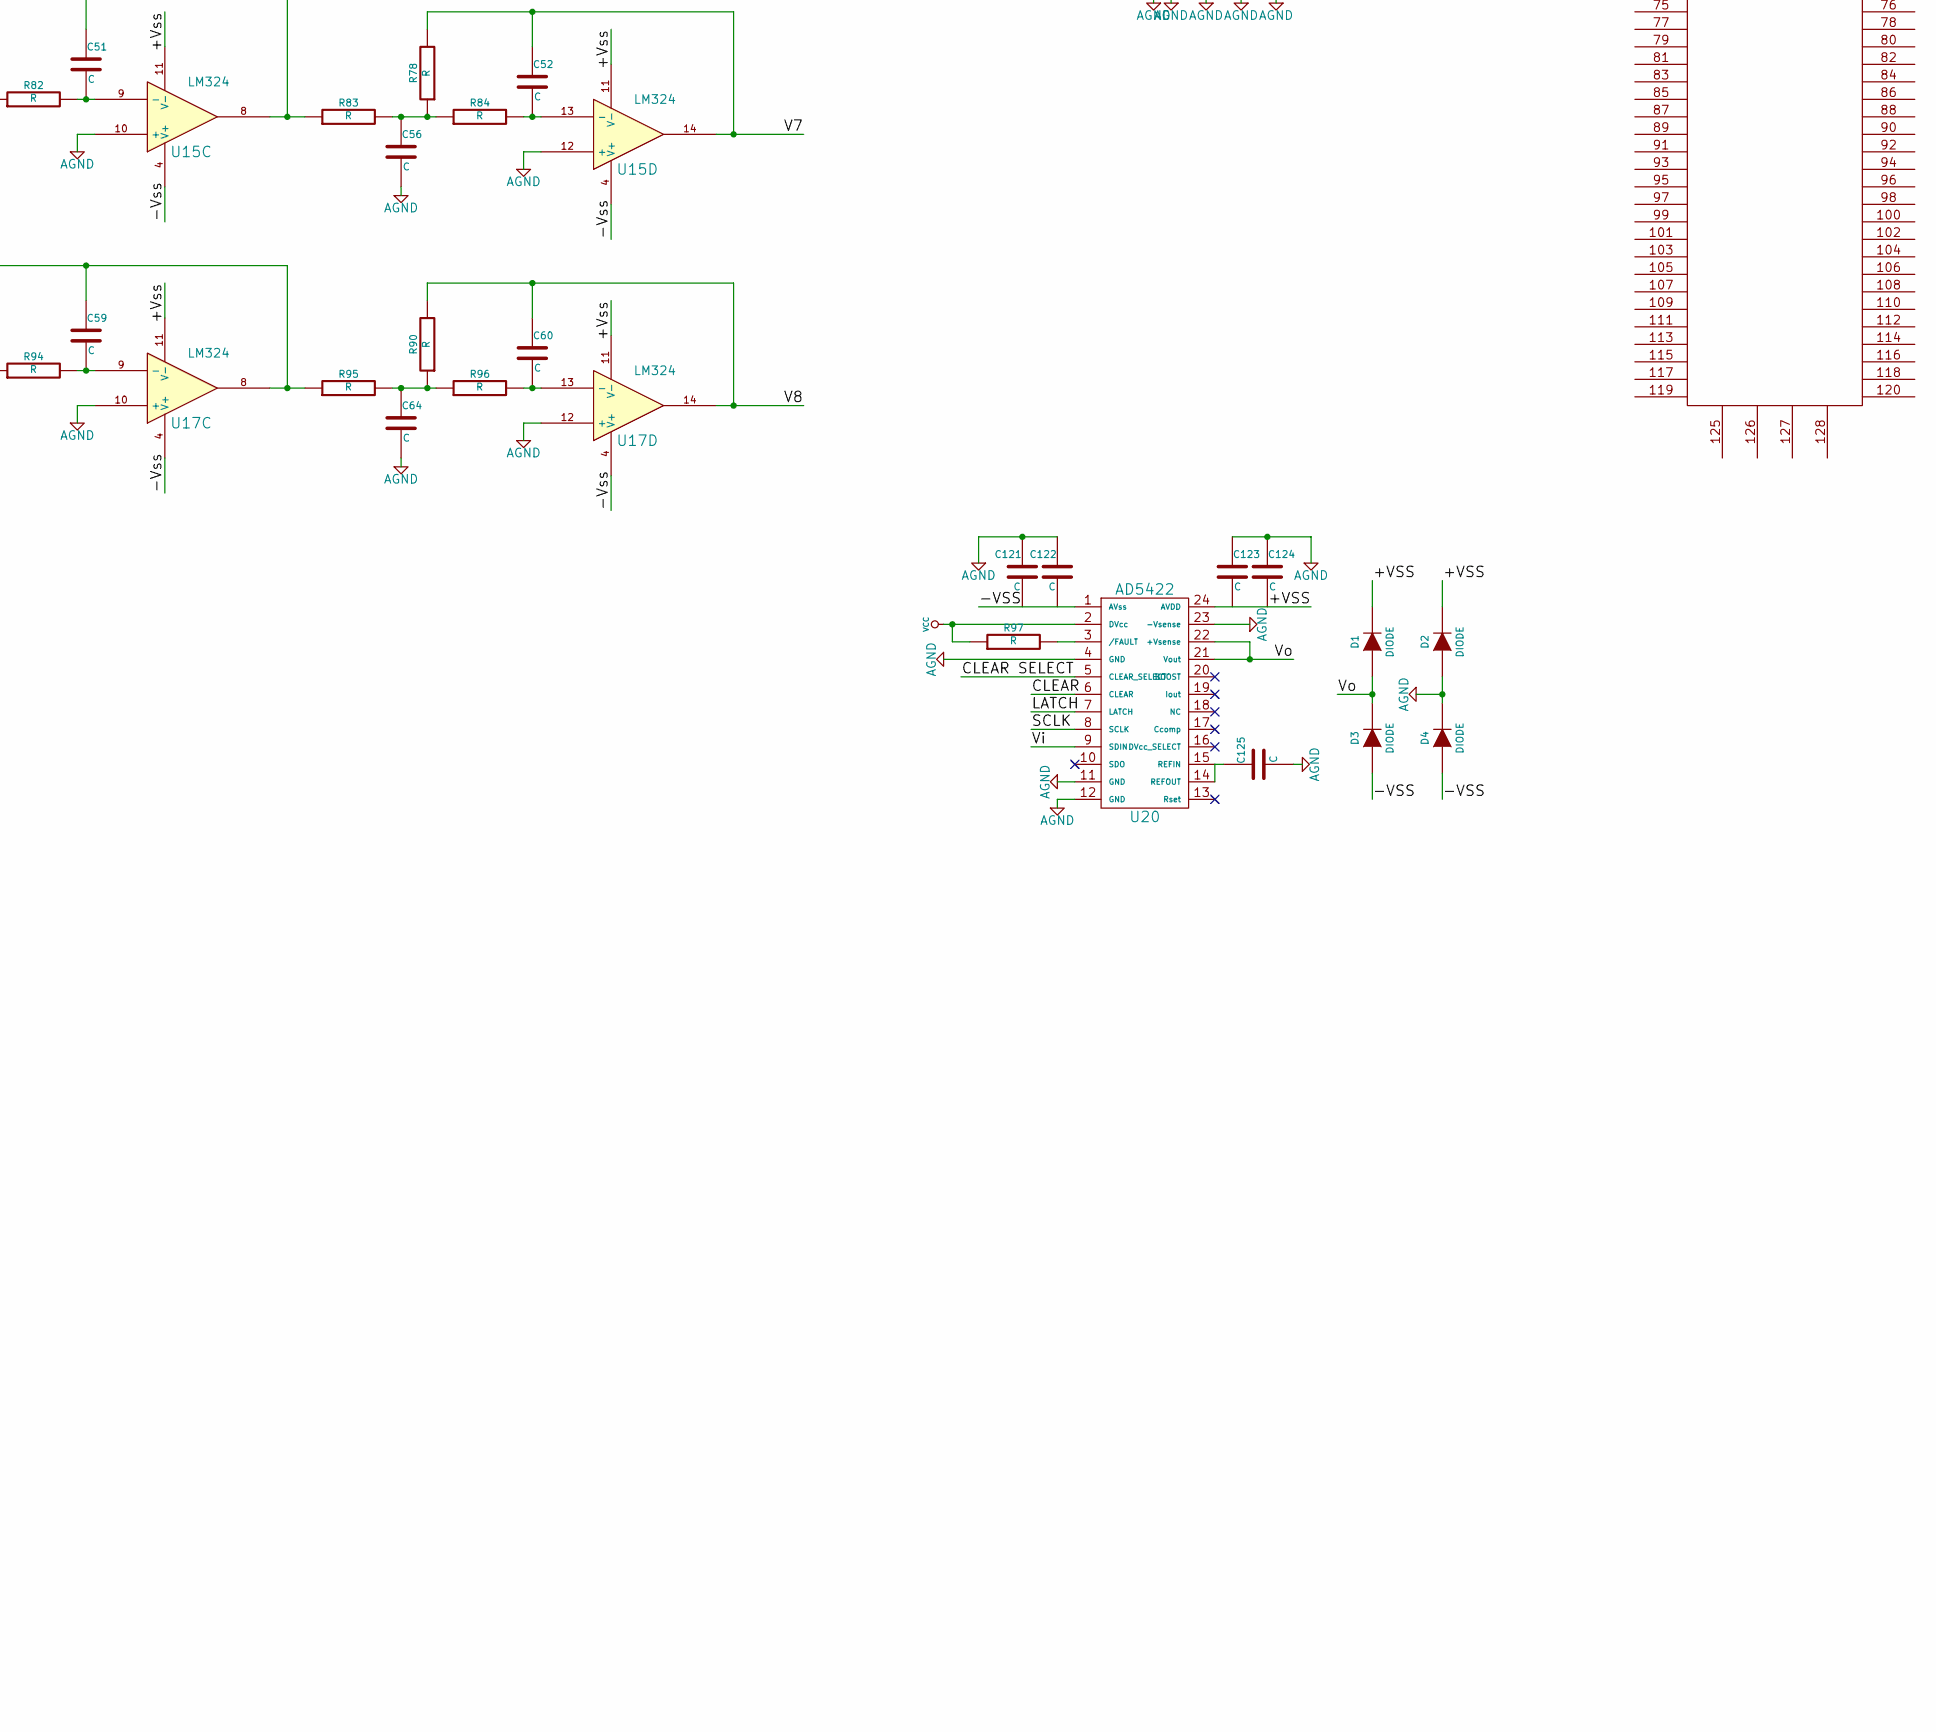
[picture p111: schematic adquisidora.sch, part in row 2, column 2]

Parts:
C1, C2, C3, C4, C5, C6, C7, C8, C9, C10, C11, C12, C13, C14, C15, C16, C17, C18, C19, C20, C21, C22, C23, C24, C25, C26, C27, C28, C29, C30, C31, C32, C33, C34, C35, C36, C37, C38, C39, C40, C41, C42, C43, C44, C45, C46, C47, C48, C49, C50, C51, C52, C53, C54, C55, C56, C57, C58, C59, C60, C61, C62, C63, C64, C65, C66, C67, C68, C69, C70, C71, C72, C73, C74, C75, C76, C77, C78, C79, C80, C81, C82, C83, C84, C85, C86, C87, C88, C89, C90, C91, C92, C93, C94, C95, C96, C97, C98, C99, C100, C101, C102, C103, C104, C105, C106, C107, C108, C109, C110, C111, C112, C113, C114, C115, C116, C117, C118, C119, C120, C121, C122, C123, C124, C125: C
D1, D2, D3, D4: DIODE
J1, J2: DB25
K1: QTH_120
R1, R2, R3, R4, R5, R6, R7, R8, R9, R10, R11, R12, R13, R14, R15, R16, R17, R18, R19, R20, R21, R22, R23, R24, R25, R26, R27, R28, R29, R30, R31, R32, R33, R34, R35, R36, R37, R38, R39, R40, R41, R42, R43, R44, R45, R46, R47, R48, R49, R50, R51, R52, R53, R54, R55, R56, R57, R58, R59, R60, R61, R62, R63, R64, R65, R66, R67, R68, R69, R70, R71, R72, R73, R74, R75, R76, R77, R78, R79, R80, R81, R82, R83, R84, R85, R86, R87, R88, R89, R90, R91, R92, R93, R94, R95, R96, R97: R
U1, U4, U6, U8, U10, U13, U16, U18, U19: ISO124
U2, U3, U5, U7, U9, U12, U15, U17: LM324
U11, U14: AD7656
U20: AD5422

Connections:
3.3V: U11.9 (V_DRIVE), U14.9 (V_DRIVE)
+VSS: D1.2 (K), D2.2 (K), U1.1 (+Vs_1), U2.11 (V-), U3.11 (V-), U4.1 (+Vs_1), U5.11 (V-), U6.1 (+Vs_1), U7.11 (V-), U8.1 (+Vs_1), U9.11 (V-), U10.1 (+Vs_1), U12.11 (V-), U13.1 (+Vs_1), U15.11 (V-), U16.1 (+Vs_1), U17.11 (V-), U18.1 (+Vs_1), U19.16 (-Vs_2), U20.24 (AVDD)
-VSS: D3.1 (A), D4.1 (A), U1.2 (-Vs_1), U2.4 (V+), U3.4 (V+), U4.2 (-Vs_1), U5.4 (V+), U6.2 (-Vs_1), U7.4 (V+), U8.2 (-Vs_1), U9.4 (V+), U10.2 (-Vs_1), U12.4 (V+), U13.2 (-Vs_1), U15.4 (V+), U16.2 (-Vs_1), U17.4 (V+), U18.2 (-Vs_1), U19.15 (+Vs_2), U20.1 (AVss)
AGND: C5.2, C6.2, C7.2, C8.2, C13.2, C14.2, C15.2, C16.2, C21.2, C22.2, C23.2, C24.2, C29.2, C30.2, C31.2, C32.2, C37.2, C38.2, C39.2, C40.2, C45.2, C46.2, C47.2, C48.2, C53.2, C54.2, C55.2, C56.2, C61.2, C62.2, C63.2, C64.2, C65.1, C66.1, C67.1, C68.1, C69.2, C70.2, C71.1, C72.1, C73.1, C74.1, C75.1, C76.1, C77.1, C78.1, C79.2, C80.2, C81.2, C82.2, C83.2, C84.2, C85.2, C86.2, C87.2, C88.2, C89.2, C90.2, C91.2, C92.2, C93.1, C94.1, C95.1, C96.1, C97.2, C98.2, C99.1, C100.1, C101.1, C102.1, C103.1, C104.1, C105.1, C106.1, C107.2, C108.2, C109.2, C110.2, C111.2, C112.2, C113.2, C114.2, C115.2, C116.2, C117.2, C118.2, C119.2, C120.2, C121.1, C122.1, C123.1, C124.1, C125.2, D2.1 (A), D4.2 (K), U1.14 (GND), U2.3 (+), U2.5 (+), U2.10 (+), U2.12 (+), U3.3 (+), U3.5 (+), U3.10 (+), U3.12 (+), U4.14 (GND), U5.3 (+), U5.5 (+), U5.10 (+), U5.12 (+), U6.14 (GND), U7.3 (+), U7.5 (+), U7.10 (+), U7.12 (+), U8.14 (GND), U9.3 (+), U9.5 (+), U9.10 (+), U9.12 (+), U10.14 (GND), U11.32 (AGND), U11.37 (AGND), U11.38 (AGND), U11.43 (AGND), U11.44 (AGND), U11.49 (AGND), U11.52 (AGND), U11.53 (AGND), U11.55 (AGND), U11.57 (AGND), U11.59 (AGND), U11.61 (SER/-PAR/SEL), U11.62 (-H/S_SEL), U12.3 (+), U12.5 (+), U12.10 (+), U12.12 (+), U13.14 (GND), U14.32 (AGND), U14.37 (AGND), U14.38 (AGND), U14.43 (AGND), U14.44 (AGND), U14.49 (AGND), U14.52 (AGND), U14.53 (AGND), U14.55 (AGND), U14.57 (AGND), U14.59 (AGND), U14.61 (SER/-PAR/SEL), U14.62 (-H/S_SEL), U15.3 (+), U15.5 (+), U15.10 (+), U15.12 (+), U16.14 (GND), U17.3 (+), U17.5 (+), U17.10 (+), U17.12 (+), U18.14 (GND), U19.28 (GND), U20.4 (GND), U20.11 (GND), U20.12 (GND), U20.23 (-Vsense)
CLEAR: U20.6 (CLEAR)
CLEAR SELECT: U20.5 (CLEAR_SELECT)
DGND: U11.8 (DGND), U11.22 (CONVST_B), U11.25 (DGND), U11.27 (RANGE), U11.29 (-W/B), U14.8 (DGND), U14.22 (CONVST_B), U14.25 (DGND), U14.27 (RANGE), U14.29 (-W/B)
LATCH: U20.7 (LATCH)
unnamed: C1.1, R1.2, R7.1, U2.1
unnamed: C1.2, R5.2, U2.2 (-)
unnamed: C2.1, R2.2, R9.1, U2.7
unnamed: C2.2, R8.2, U2.6 (-)
unnamed: C3.1, R3.2, R11.1, U2.8
unnamed: C3.2, R10.2, U2.9 (-)
unnamed: C4.2, R12.2, U2.13 (-)
unnamed: C5.1, R1.1, R4.2, R5.1
unnamed: C6.1, R2.1, R7.2, R8.1
unnamed: C7.1, R3.1, R9.2, R10.1
unnamed: C8.1, R6.1, R11.2, R12.1
unnamed: C9.1, R13.2, R19.1, U3.1
unnamed: C9.2, R17.2, U3.2 (-)
unnamed: C10.1, R14.2, R21.1, U3.7
unnamed: C10.2, R20.2, U3.6 (-)
unnamed: C11.1, R15.2, R23.1, U3.8
unnamed: C11.2, R22.2, U3.9 (-)
unnamed: C12.2, R24.2, U3.13 (-)
unnamed: C13.1, R13.1, R16.2, R17.1
unnamed: C14.1, R14.1, R19.2, R20.1
unnamed: C15.1, R15.1, R21.2, R22.1
unnamed: C16.1, R18.1, R23.2, R24.1
unnamed: C17.1, R25.2, R31.1, U5.1
unnamed: C17.2, R29.2, U5.2 (-)
unnamed: C18.1, R26.2, R33.1, U5.7
unnamed: C18.2, R32.2, U5.6 (-)
unnamed: C19.1, R27.2, R35.1, U5.8
unnamed: C19.2, R34.2, U5.9 (-)
unnamed: C20.2, R36.2, U5.13 (-)
unnamed: C21.1, R25.1, R28.2, R29.1
unnamed: C22.1, R26.1, R31.2, R32.1
unnamed: C23.1, R27.1, R33.2, R34.1
unnamed: C24.1, R30.1, R35.2, R36.1
unnamed: C25.1, R37.2, R43.1, U7.1
unnamed: C25.2, R41.2, U7.2 (-)
unnamed: C26.1, R38.2, R45.1, U7.7
unnamed: C26.2, R44.2, U7.6 (-)
unnamed: C27.1, R39.2, R47.1, U7.8
unnamed: C27.2, R46.2, U7.9 (-)
unnamed: C28.2, R48.2, U7.13 (-)
unnamed: C29.1, R37.1, R40.2, R41.1
unnamed: C30.1, R38.1, R43.2, R44.1
unnamed: C31.1, R39.1, R45.2, R46.1
unnamed: C32.1, R42.1, R47.2, R48.1
unnamed: C33.1, R49.2, R55.1, U9.1
unnamed: C33.2, R53.2, U9.2 (-)
unnamed: C34.1, R50.2, R57.1, U9.7
unnamed: C34.2, R56.2, U9.6 (-)
unnamed: C35.1, R51.2, R59.1, U9.8
unnamed: C35.2, R58.2, U9.9 (-)
unnamed: C36.2, R60.2, U9.13 (-)
unnamed: C37.1, R49.1, R52.2, R53.1
unnamed: C38.1, R50.1, R55.2, R56.1
unnamed: C39.1, R51.1, R57.2, R58.1
unnamed: C40.1, R54.1, R59.2, R60.1
unnamed: C41.1, R61.2, R67.1, U12.1
unnamed: C41.2, R65.2, U12.2 (-)
unnamed: C42.1, R62.2, R69.1, U12.7
unnamed: C42.2, R68.2, U12.6 (-)
unnamed: C43.1, R63.2, R71.1, U12.8
unnamed: C43.2, R70.2, U12.9 (-)
unnamed: C44.2, R72.2, U12.13 (-)
unnamed: C45.1, R61.1, R64.2, R65.1
unnamed: C46.1, R62.1, R67.2, R68.1
unnamed: C47.1, R63.1, R69.2, R70.1
unnamed: C48.1, R66.1, R71.2, R72.1
unnamed: C49.1, R73.2, R79.1, U15.1
unnamed: C49.2, R77.2, U15.2 (-)
unnamed: C50.1, R74.2, R81.1, U15.7
unnamed: C50.2, R80.2, U15.6 (-)
unnamed: C51.1, R75.2, R83.1, U15.8
unnamed: C51.2, R82.2, U15.9 (-)
unnamed: C52.2, R84.2, U15.13 (-)
unnamed: C53.1, R73.1, R76.2, R77.1
unnamed: C54.1, R74.1, R79.2, R80.1
unnamed: C55.1, R75.1, R81.2, R82.1
unnamed: C56.1, R78.1, R83.2, R84.1
unnamed: C57.1, R85.2, R91.1, U17.1
unnamed: C57.2, R89.2, U17.2 (-)
unnamed: C58.1, R86.2, R93.1, U17.7
unnamed: C58.2, R92.2, U17.6 (-)
unnamed: C59.1, R87.2, R95.1, U17.8
unnamed: C59.2, R94.2, U17.9 (-)
unnamed: C60.2, R96.2, U17.13 (-)
unnamed: C61.1, R85.1, R88.2, R89.1
unnamed: C62.1, R86.1, R91.2, R92.1
unnamed: C63.1, R87.1, R93.2, R94.1
unnamed: C64.1, R90.1, R95.2, R96.1
unnamed: C81.1, C82.1, U11.50 (AVCC)
unnamed: C83.1, C84.1, U11.51 (REF_IN/REF_OUT)
unnamed: C85.1, C86.1, U11.54 (REFCAPA)
unnamed: C87.1, C88.1, U11.56 (REFCAPB)
unnamed: C89.1, C90.1, U11.58 (REFCAPC)
unnamed: C91.1, C92.1, U11.60 (AVCC)
unnamed: C109.1, C110.1, U14.50 (AVCC)
unnamed: C111.1, C112.1, U14.51 (REF_IN/REF_OUT)
unnamed: C113.1, C114.1, U14.54 (REFCAPA)
unnamed: C115.1, C116.1, U14.56 (REFCAPB)
unnamed: C117.1, C118.1, U14.58 (REFCAPC)
unnamed: C119.1, C120.1, U14.60 (AVCC)
unnamed: C125.1, U20.14 (REFOUT), U20.15 (REFIN)
unnamed: R97.2, U20.3 (/FAULT)
SCLK: U20.8 (SCLK)
V1: C4.1, R6.2, U2.14, U11.33 (V1)
V2: C12.1, R18.2, U3.14, U11.36 (V2)
V3: C20.1, R30.2, U5.14, U11.45 (V5)
V4: C28.1, R42.2, U7.14, U11.48 (V6)
V5: C36.1, R54.2, U9.14, U14.33 (V1)
V6: C44.1, R66.2, U12.14, U14.36 (V2)
V7: C52.1, R78.2, U14.45 (V5), U15.14
V8: C60.1, R90.2, U14.48 (V6), U17.14
V DRIVE: U11.24 (-STBY), U14.24 (-STBY)
VCC: C69.1, C70.1, C71.2, C72.2, C73.2, C74.2, C76.2, C77.2, C78.2, C79.1, C80.1, C97.1, C98.1, C99.2, C100.2, C101.2, C102.2, C104.2, C105.2, C106.2, C107.1, C108.1, R97.1, U11.26 (DVCC), U11.34 (AVCC), U11.35 (AVCC), U11.40 (AVCC), U11.41 (AVCC), U11.46 (AVCC), U11.47 (AVCC), U11.63 (-WR/REF_en/-dis), U14.26 (DVCC), U14.34 (AVCC), U14.35 (AVCC), U14.40 (AVCC), U14.41 (AVCC), U14.46 (AVCC), U14.47 (AVCC), U14.63 (-WR/REF_en/-dis), U20.2 (DVcc)
VDD: C67.2, C68.2, C95.2, C96.2, U11.31 (VDD), U14.31 (VDD)
VSS: C65.2, C66.2, C93.2, C94.2, U11.30 (VSS), U14.30 (VSS)
Vi: U20.9 (SDIN)
Vo: D1.1 (A), D3.2 (K), U19.27 (V_in), U20.21 (Vout), U20.22 (+Vsense)
