Francisco89/tesis/WorkspaceQt/streamer/streamer_nuevo/main.cpp

//////////////////////////////////////////////////////////////////////////////////////////////
//                                                                                          //
// Streamer casero                                                                          //
// Para ocuparlo hay que poner el firmware USBBulkSourceSink                                //
//                                                                                          //
//////////////////////////////////////////////////////////////////////////////////////////////

#include "widget.h"
#include <QApplication>
#include <CyAPI.h>
#include <iostream>

int main(int argc, char *argv[])
{
    using namespace std;
    QApplication a(argc, argv);
    Widget w;
    w.show();

    return a.exec();
}
