Francisco89/tesis/WorkspaceQt/streamer/streamer_nuevo/mainwindow.h

#ifndef MAINWINDOW_H
#define MAINWINDOW_H

#include <QMainWindow>
#include "CyAPI.h"
#include <iostream>

namespace Ui {
class MainWindow;
}

class MainWindow : public QMainWindow
{
    Q_OBJECT
    
public:
    explicit MainWindow(QWidget *parent = 0);
    ~MainWindow();
    
private:
    Ui::MainWindow *ui;

private slots:
    void Start_pushButton_click();
};

#endif // MAINWINDOW_H
