Francisco89/tesis/Eclipse/AutoMaster/cyfxbulklpauto.h

/*
 ## Cypress USB 3.0 Platform header file (cyfxbulklpauto.h)
 ## ===========================
 ##
 ##  Copyright Cypress Semiconductor Corporation, 2010-2011,
 ##  All Rights Reserved
 ##  UNPUBLISHED, LICENSED SOFTWARE.
 ##
 ##  CONFIDENTIAL AND PROPRIETARY INFORMATION
 ##  WHICH IS THE PROPERTY OF CYPRESS.
 ##
 ##  Use of this file is governed
 ##  by the license agreement included in the file
 ##
 ##     <install>/license/license.txt
 ##
 ##  where <install> is the Cypress software
 ##  installation root directory path.
 ##
 ## ===========================
*/

/* This file contains the externants used by the bulk loop application example */

#ifndef _INCLUDED_CYFXBULKLPAUTO_H_
#define _INCLUDED_CYFXBULKLPAUTO_H_

#include "cyu3types.h"
#include "cyu3usbconst.h"
#include "cyu3externcstart.h"

/* 16/32 bit GPIF Configuration select */
/* Set CY_FX_MA_GPIF_16_32BIT_CONF_SELECT = 0 for 16 bit GPIF data bus.
 * Set CY_FX_MA_GPIF_16_32BIT_CONF_SELECT = 1 for 32 bit GPIF data bus.
 */
#define CY_FX_GPIF_16_32BIT_CONF_SELECT (0)

#define CY_FX_DMA_BUF_COUNT      (16)                       /* Master channel buffer count */
#define CY_FX_DMA_TX_SIZE        (0)                        /* DMA transfer size is set to infinite */
#define CY_FX_THREAD_STACK       (0x0400)                   /* Master application thread stack size */
#define CY_FX_THREAD_PRIORITY    (8)                        /* Master application thread priority */

/* Endpoint and socket definitions for the bulkloop application */

/* To change the producer and consumer EP enter the appropriate EP numbers for the #defines.
 * In the case of IN endpoints enter EP number along with the direction bit.
 * For eg. EP 6 IN endpoint is 0x86
 *     and EP 6 OUT endpoint is 0x06.
 * To change sockets mention the appropriate socket number in the #defines. */

/* Note: For USB 2.0 the endpoints and corresponding sockets are one-to-one mapped
         i.e. EP 1 is mapped to UIB socket 1 and EP 2 to socket 2 so on */

#define CY_FX_EP_PRODUCER               0x01    /* EP 1 OUT */
#define CY_FX_EP_CONSUMER               0x81    /* EP 1 IN */

#define CY_FX_PRODUCER_USB_SOCKET        CY_U3P_UIB_SOCKET_PROD_1    /* Socket 1 is producer */
#define CY_FX_CONSUMER_USB_SOCKET        CY_U3P_UIB_SOCKET_CONS_1    /* Socket 1 is consumer */

/* Used with FX3 Silicon. */
#define CY_FX_PRODUCER_PPORT_SOCKET    CY_U3P_PIB_SOCKET_0    /* P-port Socket 0 is producer */
#define CY_FX_CONSUMER_PPORT_SOCKET    CY_U3P_PIB_SOCKET_1    /* P-port Socket 1 is consumer */

/* Burst length in 1 KB packets. Only applicable to USB 3.0. */
#define CY_FX_EP_BURST_LENGTH          (1)
/* Multiplication factor used when allocating DMA buffers to reduce DMA callback frequency. */
#define CY_FX_DMA_SIZE_MULTIPLIER      (1)


/* Extern definitions for the USB Descriptors */
extern const uint8_t CyFxUSB20DeviceDscr[];
extern const uint8_t CyFxUSB30DeviceDscr[];
extern const uint8_t CyFxUSBDeviceQualDscr[];
extern const uint8_t CyFxUSBFSConfigDscr[];
extern const uint8_t CyFxUSBHSConfigDscr[];
extern const uint8_t CyFxUSBBOSDscr[];
extern const uint8_t CyFxUSBSSConfigDscr[];
extern const uint8_t CyFxUSBStringLangIDDscr[];
extern const uint8_t CyFxUSBManufactureDscr[];
extern const uint8_t CyFxUSBProductDscr[];

#include "cyu3externcend.h"

#endif /* _INCLUDED_CYFXBULKLPAUTO_H_ */

/*[]*/
