Francisco89/tesis/WorkspaceQt/streamer/streamer_nuevo/widget.h

#ifndef WIDGET_H
#define WIDGET_H

#include <QWidget>
#include "CyAPI.h"
#include <iostream>

namespace Ui {
class Widget;
}

class Widget : public QWidget
{
    Q_OBJECT

public:
    explicit Widget(QWidget *parent = 0);
    ~Widget();

private:
    Ui::Widget *ui;

};

#endif // WIDGET_H
