Francisco89/tesis/(commit log)

2013-09-10 borre el readme
2013-09-18 Copie el proyecto de la compu de Ricardo, lo recompile en esta compu y escribi el tutorial sobre como lo hicimos.
2013-09-23 Primera parte del streamer, puedo leer endpoints con el sourcesink en mi streamer casero. Falta mejorar la programacion, poner headers y sacar cosas del main
2013-09-23 Leer mensaje de recien
2013-09-24 24 del 9, fui a ver a Haykin, estoy tratando de agregar la funcion del loopback al programa.
2013-09-24 Puedo escribir el endpoint pero no puedo leer con XferData
2013-09-25 Guardo una version del streamer que escribe un endpoint OUT y lee un endpoint IN que funciona HOY
2013-10-07 Agrego las cosas que borre
2013-10-15 Agrego dos tutoriales en txt, PWM y PPort. Agrego tambien el firmware y creo que las maquinas de estado que usan en la carpeta workspace eclipse.
2013-10-16 el proyecto de Qt usb2gpio ahora efectivamente crea un PWM y lo escribe en el endpoint de salida identificado en el codigo, el cual se puede cambiar a gusto.
2013-10-29 Automaster (eclipse) y usb2gpio (qt) actualizados. Es un streamning al puerto GPIF II por USB que prende 16 bits (prende 16, no LOS 16 que dice la placa pero hay 16). El automaster es un master FIFO 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
2013-10-30 Lo que hice hoy: probe que la maquina puede mandar un LONG con su numero maximo cada 1us, sacando en pantalla cada 1s. Paso siguiente, ver si puede hacer un loopback con un DMA automatico de un endpo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
2013-11-07 Tal y como sospechaba, el buffer del usb se drena de a 16 bit (u 8, 24 o 32, a gusto del consumidor) al puerto USB. Por ende escribi un patron distinto y se va imprimiendo cada 16 bits al puerto usb.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
2014-01-17 agrego la carpeta placa adquisidora
    [ACONDICIONADORES_PA.DSN, acondicionadores_pa.opj]
2014-01-17 agrego los bloques y los componentes elegidos hasta ahora
    [Componentes Placa.ods]
2014-04-21 Actualizacion GIT 21 04 14 salvar archivos
    [.kicad_pcb.kicad_pcb, ADC1.sch, ADC2.sch, Adquisidora.sch, AislacionesAnalogicas.sch, AislacionesDigitales.sch, AislacionesDigitales2.sch, DAC.sch]
